ZeduloTech/gf180mcu-testchip2025/librelane/config.yaml

meta:
  version: 3
  flow: Chip
  substituting_steps:
  
    # Disable KLayout antenna check
    KLayout.Antenna: null
    Checker.KLayoutAntenna: null

    # Disable KLayout density check
    #KLayout.Density: null
    #Checker.KLayoutDensity: null

    # Save time during development
    # Enable for sign-off
    #KLayout.DRC: null
    #Checker.KLayoutDRC: null
    #OpenROAD.IRDropReport: null
    #Magic.DRC: null
    #Magic.Streamout: null
    #Checker.MagicDRC: null
    #KLayout.XOR: null
    #Netgen.LVS: null
    #Checker.LVS: null
    #Verilator.Lint: null
    
    Checker.YosysSynthChecks: null  # Fails due to multisources in PLL

DESIGN_NAME: chip_top
VERILOG_FILES:
- dir::../src/chip_top.sv
- dir::../src/chip_core.sv
- dir::../src/wb_reg.v
- dir::../src/wb_mux_5.v
- dir::../src/wb_switch.v
- dir::../src/wb_efuses.v
- dir::../src/wb_async_efuse.v
- dir::../src/sramtest/uspi_sramtest.sv

VERILOG_INCLUDE_DIRS: [ dir::../caravel/verilog/ ]

# Slightly smaller file sizes
PRIMARY_GDSII_STREAMOUT_TOOL: klayout

# SDC files
PNR_SDC_FILE: dir::chip_top.sdc
SIGNOFF_SDC_FILE: dir::chip_top.sdc
FALLBACK_SDC: dir::chip_top.sdc

# Power / ground nets
VDD_NETS:
- VDD
GND_NETS:
- VSS

# We need to add gf180mcu_fd_io__bi_24t
# due to the unused Y output for output only pads
IGNORE_DISCONNECTED_MODULES:
- gf180mcu_fd_io__bi_24t
- gf180mcu_ws_ip__id
- gf180mcu_ws_ip__logo

# Clock
#CLOCK_NET: i_chip_core.caravel/user_wb_clk_o
CLOCK_NET: i_chip_core.wb_clk_buf/Z

CLOCK_PERIOD: 45 # 22 MHz

# Increase timing margins
PL_RESIZER_HOLD_SLACK_MARGIN: 0.7
PL_RESIZER_SETUP_SLACK_MARGIN: 0.4
MAX_TRANSITION_CONSTRAINT: 1.0
PL_RESIZER_GATE_CLONING: False
PL_RESIZER_SETUP_BUFFERING: False
PL_KEEP_RESIZE_BELOW_OVERFLOW: 0
RSZ_DONT_TOUCH_RX: .*clk_buf

# Floorplanning
PL_TARGET_DENSITY_PCT: 25
GRT_ALLOW_CONGESTION: true

# PDN
PDN_CORE_RING: True
# Maximum metal width without slotting: 30um
PDN_CORE_RING_VWIDTH: 25
PDN_CORE_RING_HWIDTH: 25
PDN_CORE_RING_CONNECT_TO_PADS: True
PDN_ENABLE_PINS: False
PDN_CORE_VERTICAL_LAYER: Metal2
PDN_CORE_HORIZONTAL_LAYER: Metal3
PDN_HPITCH: 50

# To disable ports buffering & wire repair with dly cells as they degrade timing
PNR_EXCLUDED_CELL_FILE: dir::../caravel/librelane/pnr_exclude.cells

# To fix antennas
DESIGN_REPAIR_MAX_WIRE_LENGTH: 2000
DIODE_ON_PORTS: both
GRT_ANTENNA_MARGIN: 30
GRT_ANTENNA_ITERS: 10
DRT_ANTENNA_REPAIR_ITERS: 10

# Prevent false positive DRC errors in I/O cells
MAGIC_GDS_FLATGLOB:
# For contacts
- "*_CDNS_*"
# Foundry provided SRAMs
- "*$$*"
- "M1_N*"
- "M1_P*"
- "M2_M1*"
- "M3_M2*"
- "nmos_5p0*"
- "nmos_1p2*"
- "pmos_5p0*"
- "pmos_1p2*"
- "via1_*"
- "ypass_gate*"
- "G_ring_*"
# These additional cells must be flattened to get rid of 3.3V devices
# (DUALGATE drawn into high-level cells)
- "dcap_103*"
- "din_*"
- "mux821_*"
- "rdummy_*"
- "pmoscap_*"
- "xdec_*"
- "ypredec*"
- "xpredec*"
- "prexdec_*"
- "xdec8_*"
- "xdec16_*"
- "xdec32_*"
- "sa_*"

# Since we cannot meet the minimum density limit on Metal2,
# ignore active metal on previous and subsequent layers
# (DM.5_DM.7 and DM.4_DM.6). Dummy metal is moved to active
# metal during the precheck.
KLAYOUT_FILLER_OPTIONS:
  Metal2_ignore_active: true

# Because we have multiple power pads for one power domain
MAGIC_EXT_UNIQUE: notopports

MACROS:
  gf180mcu_ws_ip__id:
    gds:
      - dir::../ip/gf180mcu_ws_ip__id/gds/gf180mcu_ws_ip__id.gds
    lef:
      - dir::../ip/gf180mcu_ws_ip__id/lef/gf180mcu_ws_ip__id.lef
    vh:
      - dir::../ip/gf180mcu_ws_ip__id/vh/gf180mcu_ws_ip__id.v
    lib:
      "*":
        - dir::../ip/gf180mcu_ws_ip__id/lib/gf180mcu_ws_ip__id.lib
    instances:
      chip_id:
        location: [26, 26]
        orientation: N

  gf180mcu_ws_ip__logo:
    gds:
      - dir::../ip/gf180mcu_ws_ip__logo/gds/gf180mcu_ws_ip__logo.gds
    lef:
      - dir::../ip/gf180mcu_ws_ip__logo/lef/gf180mcu_ws_ip__logo.lef
    vh:
      - dir::../ip/gf180mcu_ws_ip__logo/vh/gf180mcu_ws_ip__logo.v
    lib:
      "*":
        - dir::../ip/gf180mcu_ws_ip__logo/lib/gf180mcu_ws_ip__logo.lib
    instances:
      wafer_space_logo:
        location: ["expr::$DIE_AREA[2] + -169.25", "expr::$DIE_AREA[3] + -169.25"]
        orientation: N
        
  caravel_core:
    gds:
      - dir::../caravel/final/gds/caravel_core.gds.gz
    lef:
      - dir::../caravel/final/lef/caravel_core.lef
    pnl:
      - dir::../caravel/final/pnl/caravel_core.pnl.v
    lib:
      "*tt*" : [ dir::../caravel/final/lib/nom_tt_025C_5v00/caravel_core__nom_tt_025C_5v00.lib ]
      "*ss*" : [ dir::../caravel/final/lib/max_ss_125C_4v50/caravel_core__max_ss_125C_4v50.lib ]
      "*ff*" : [ dir::../caravel/final/lib/min_ff_n40C_5v50/caravel_core__min_ff_n40C_5v50.lib ]
    spef:
      "*tt*" : [ dir::../caravel/final/spef/nom/caravel_core.nom.spef.gz ]
      "*ss*" : [ dir::../caravel/final/spef/max/caravel_core.max.spef.gz ]
      "*ff*" : [ dir::../caravel/final/spef/min/caravel_core.min.spef.gz ]
    instances:
      i_chip_core.caravel:
        location: [500, 500]
        orientation: N

  efuse_wb_mem_1024x32:
    gds:
      - dir::../ip/efuse_wb_mem_1024x32/efuse_wb_mem_1024x32.gds
    lef:
      - dir::../ip/efuse_wb_mem_1024x32/efuse_wb_mem_1024x32.lef
    pnl:
      - dir::../ip/efuse_wb_mem_1024x32/efuse_wb_mem_1024x32.pnl.v
    lib:
      "*tt*" : [ dir::../ip/efuse_wb_mem_1024x32/min_tt_025C_5v00/efuse_wb_mem_1024x32__min_tt_025C_5v00.lib ]
      "*ss*" : [ dir::../ip/efuse_wb_mem_1024x32/max_ss_125C_4v50/efuse_wb_mem_1024x32__max_ss_125C_4v50.lib ]
      "*ff*" : [ dir::../ip/efuse_wb_mem_1024x32/max_ff_n40C_5v50/efuse_wb_mem_1024x32__max_ff_n40C_5v50.lib ]
    instances:
      i_chip_core.wb_efuses.efuse_wb_1024x32:
        location: [500, 1600]
        orientation: S

  efuse_wb_mem_64x32:
    gds:
      - dir::../ip/efuse_wb_mem_64x32/efuse_wb_mem_64x32.gds
    lef:
      - dir::../ip/efuse_wb_mem_64x32/efuse_wb_mem_64x32.lef
    pnl:
      - dir::../ip/efuse_wb_mem_64x32/efuse_wb_mem_64x32.pnl.v
    lib:
      "*tt*" : [ dir::../ip/efuse_wb_mem_64x32/min_tt_025C_5v00/efuse_wb_mem_64x32__min_tt_025C_5v00.lib ]
      "*ss*" : [ dir::../ip/efuse_wb_mem_64x32/max_ss_125C_4v50/efuse_wb_mem_64x32__max_ss_125C_4v50.lib ]
      "*ff*" : [ dir::../ip/efuse_wb_mem_64x32/max_ff_n40C_5v50/efuse_wb_mem_64x32__max_ff_n40C_5v50.lib ]
    instances:
      i_chip_core.wb_efuses.efuse_wb_64x32:
        location: [3120, 3050]
        orientation: S

  efuse_wb_mem_128x8:
    gds:
      - dir::../ip/efuse_wb_mem_128x8/efuse_wb_mem_128x8.gds
    lef:
      - dir::../ip/efuse_wb_mem_128x8/efuse_wb_mem_128x8.lef
    pnl:
      - dir::../ip/efuse_wb_mem_128x8/efuse_wb_mem_128x8.pnl.v
    lib:
      "*tt*" : [ dir::../ip/efuse_wb_mem_128x8/min_tt_025C_5v00/efuse_wb_mem_128x8__min_tt_025C_5v00.lib ]
      "*ss*" : [ dir::../ip/efuse_wb_mem_128x8/max_ss_125C_4v50/efuse_wb_mem_128x8__max_ss_125C_4v50.lib ]
      "*ff*" : [ dir::../ip/efuse_wb_mem_128x8/max_ff_n40C_5v50/efuse_wb_mem_128x8__max_ff_n40C_5v50.lib ]
    instances:
      i_chip_core.wb_efuses.efuse_wb_128x8:
        location: [2550, 3020]
        orientation: S

  efuse_wb_mem_32x8:
    gds:
      - dir::../ip/efuse_wb_mem_32x8/efuse_wb_mem_32x8.gds
    lef:
      - dir::../ip/efuse_wb_mem_32x8/efuse_wb_mem_32x8.lef
    pnl:
      - dir::../ip/efuse_wb_mem_32x8/efuse_wb_mem_32x8.pnl.v
    lib:
      "*tt*" : [ dir::../ip/efuse_wb_mem_32x8/min_tt_025C_5v00/efuse_wb_mem_32x8__min_tt_025C_5v00.lib ]
      "*ss*" : [ dir::../ip/efuse_wb_mem_32x8/max_ss_125C_4v50/efuse_wb_mem_32x8__max_ss_125C_4v50.lib ]
      "*ff*" : [ dir::../ip/efuse_wb_mem_32x8/max_ff_n40C_5v50/efuse_wb_mem_32x8__max_ff_n40C_5v50.lib ]
    instances:
      i_chip_core.wb_efuses.efuse_wb_32x8:
        location: [2650, 3500]
        orientation: S

  efuse_spi_mem_256x8:
    gds:
      - dir::../ip/efuse_spi_mem_256x8/efuse_spi_mem_256x8.gds
    lef:
      - dir::../ip/efuse_spi_mem_256x8/efuse_spi_mem_256x8.lef
    pnl:
      - dir::../ip/efuse_spi_mem_256x8/efuse_spi_mem_256x8.pnl.v
    lib:
      "*tt*" : [ dir::../ip/efuse_spi_mem_256x8/min_tt_025C_5v00/efuse_spi_mem_256x8__min_tt_025C_5v00.lib ]
      "*ss*" : [ dir::../ip/efuse_spi_mem_256x8/max_ss_125C_4v50/efuse_spi_mem_256x8__max_ss_125C_4v50.lib ]
      "*ff*" : [ dir::../ip/efuse_spi_mem_256x8/max_ff_n40C_5v50/efuse_spi_mem_256x8__max_ff_n40C_5v50.lib ]
    instances:
      i_chip_core.efuse_spi:
        location: [1400, 3500]
        orientation: N

  efuse_async_mem_1x8:
    gds:
      - dir::../ip/efuse_async_mem_1x8/efuse_async_mem_1x8.gds
    lef:
      - dir::../ip/efuse_async_mem_1x8/efuse_async_mem_1x8.lef
    pnl:
      - dir::../ip/efuse_async_mem_1x8/efuse_async_mem_1x8.pnl.v
    lib:
      "*tt*" : [ dir::../ip/efuse_async_mem_1x8/min_tt_025C_5v00/efuse_async_mem_1x8__min_tt_025C_5v00.lib ]
      "*ss*" : [ dir::../ip/efuse_async_mem_1x8/max_ss_125C_4v50/efuse_async_mem_1x8__max_ss_125C_4v50.lib ]
      "*ff*" : [ dir::../ip/efuse_async_mem_1x8/max_ff_n40C_5v50/efuse_async_mem_1x8__max_ff_n40C_5v50.lib ]
    instances:
      i_chip_core.efuse_async:
        location: [1000, 3015]
        orientation: N
      i_chip_core.wb_efuses.efuse_wb_async.efuse[0].efuse_async:
        location: [2030, 3015]                    
        orientation: N                            
      i_chip_core.wb_efuses.efuse_wb_async.efuse[1].efuse_async:
        location: [2030, 3115]                    
        orientation: N                            
      i_chip_core.wb_efuses.efuse_wb_async.efuse[2].efuse_async:
        location: [2030, 3215]                    
        orientation: N                            
      i_chip_core.wb_efuses.efuse_wb_async.efuse[3].efuse_async:
        location: [2030, 3315]
        orientation: N

#495	0	4150
#350	145	4295
#280	215	4365
#245	250	4400

  gf180_ram_64x8_wrapper:
    gds:
      - dir::../ip/sram/gf180_ram_64x8_wrapper.gds.gz
    lef:
      - dir::../ip/sram/gf180_ram_64x8_wrapper.lef
    nl:
      - dir::../ip/sram/gf180_ram_64x8_wrapper.v
    lib:
      "*tt*" : [ dir::../ip/sram/gf180_ram_64x8_wrapper__tt_025C_5v00.lib ]
      "*ss*" : [ dir::../ip/sram/gf180_ram_64x8_wrapper__ss_125C_4v50.lib ]
      "*ff*" : [ dir::../ip/sram/gf180_ram_64x8_wrapper__ff_n40C_5v50.lib ]
      
    instances:  
      i_chip_core.sram_test_0.sram64_0:
        location: [500, 4350]
        orientation: N

  gf180_ram_128x8_wrapper:
    gds:
      - dir::../ip/sram/gf180_ram_128x8_wrapper.gds.gz
    lef:
      - dir::../ip/sram/gf180_ram_128x8_wrapper.lef
    nl:
      - dir::../ip/sram/gf180_ram_128x8_wrapper.v
    lib:
      "*tt*" : [ dir::../ip/sram/gf180_ram_128x8_wrapper__tt_025C_5v00.lib ]
      "*ss*" : [ dir::../ip/sram/gf180_ram_128x8_wrapper__ss_125C_4v50.lib ]
      "*ff*" : [ dir::../ip/sram/gf180_ram_128x8_wrapper__ff_n40C_5v50.lib ]
      
    instances:  
      i_chip_core.sram_test_0.sram128_0:
        location: [1000, 4315]
        orientation: N

  gf180_ram_256x8_wrapper:
    gds:
      - dir::../ip/sram/gf180_ram_256x8_wrapper.gds.gz
    lef:
      - dir::../ip/sram/gf180_ram_256x8_wrapper.lef
    nl:
      - dir::../ip/sram/gf180_ram_256x8_wrapper.v
    lib:
      "*tt*" : [ dir::../ip/sram/gf180_ram_256x8_wrapper__tt_025C_5v00.lib ]
      "*ss*" : [ dir::../ip/sram/gf180_ram_256x8_wrapper__ss_125C_4v50.lib ]
      "*ff*" : [ dir::../ip/sram/gf180_ram_256x8_wrapper__ff_n40C_5v50.lib ]
      
    instances:  
      i_chip_core.sram_test_0.sram256_0:
        location: [1500, 4245]
        orientation: N

  gf180_ram_512x8_wrapper:
    gds:
      - dir::../ip/sram/gf180_ram_512x8_wrapper.gds.gz
    lef:
      - dir::../ip/sram/gf180_ram_512x8_wrapper.lef
    nl:
      - dir::../ip/sram/gf180_ram_512x8_wrapper.v
    lib:
      "*tt*" : [ dir::../ip/sram/gf180mcu_fd_ip_sram__sram512x8m8wm1__tt_025C_5v00.lib ]
      "*ss*" : [ dir::../ip/sram/gf180mcu_fd_ip_sram__sram512x8m8wm1__ss_125C_4v50.lib ]
      "*ff*" : [ dir::../ip/sram/gf180mcu_fd_ip_sram__sram512x8m8wm1__ff_n40C_5v50.lib ]
      
    instances:  
      i_chip_core.sram_test_0.sram512_0:
        location: [2000, 4100]
        orientation: N

  uart2gpi:
    gds:
      - dir::../uart2gpi/final/gds/uart2gpi.gds.gz
    lef:
      - dir::../uart2gpi/final/lef/uart2gpi.lef
    nl:
      - dir::../uart2gpi/final/nl/uart2gpi.nl.v
    lib:
      "*tt*" : [ dir::../uart2gpi/final/lib/nom_tt_025C_5v00/uart2gpi__nom_tt_025C_5v00.lib ]
      "*ss*" : [ dir::../uart2gpi/final/lib/nom_ss_125C_4v50/uart2gpi__nom_ss_125C_4v50.lib ]
      "*ff*" : [ dir::../uart2gpi/final/lib/nom_ff_n40C_5v50/uart2gpi__nom_ff_n40C_5v50.lib ]
      
    instances:  
      i_chip_core.uart2gpi_0:
        location: [500, 3450]
        orientation: N


# Make sure netgen doesn't create 'no_connect' nets
# Not needed since netgen 1.5.303
LVS_FLATTEN_CELLS:
- gf180mcu_ws_ip__id
- gf180mcu_ws_ip__logo

# gf180mcu_ws_ip__id/logo has no ports and components
# therefore make it an abstract cell in the layout
MAGIC_EXT_ABSTRACT_CELLS:
- gf180mcu_ws_ip__id
- gf180mcu_ws_ip__logo
