ZeduloTech/gf180mcu-testchip2025/src/chip_top.sv

// SPDX-FileCopyrightText: © 2025 Project Template Contributors
// SPDX-License-Identifier: Apache-2.0

`default_nettype none

`include "slot_defines.svh"

module chip_top #(
    // Power/ground pads for core and I/O
    parameter NUM_DVDD_PADS = `NUM_DVDD_PADS,
    parameter NUM_DVSS_PADS = `NUM_DVSS_PADS,

    // Signal pads
    parameter NUM_INPUT_PADS = `NUM_INPUT_PADS,
    parameter NUM_BIDIR_PADS = `NUM_BIDIR_PADS,
    parameter NUM_ANALOG_PADS = `NUM_ANALOG_PADS
    )(
    `ifdef USE_POWER_PINS
    inout  wire VDD,
    inout  wire VSS,
    `endif

    inout  wire clk_PAD,
    inout  wire rst_n_PAD,

    `ifndef NO_ANALOG_PADS    
    inout  wire [NUM_ANALOG_PADS-1:0] analog_PAD,
    `endif
    
    inout  wire [NUM_INPUT_PADS-1:0] input_PAD,
    inout  wire [NUM_BIDIR_PADS-1:0] bidir_PAD
);

    wire clk_PAD2CORE;
    wire rst_n_PAD2CORE;
    
    wire [NUM_INPUT_PADS-1:0] input_PAD2CORE;
    wire [NUM_INPUT_PADS-1:0] input_CORE2PAD_PU;
    wire [NUM_INPUT_PADS-1:0] input_CORE2PAD_PD;

    wire [NUM_BIDIR_PADS-1:0] bidir_PAD2CORE;
    wire [NUM_BIDIR_PADS-1:0] bidir_CORE2PAD;
    wire [NUM_BIDIR_PADS-1:0] bidir_CORE2PAD_OE;
    wire [NUM_BIDIR_PADS-1:0] bidir_CORE2PAD_CS;
    wire [NUM_BIDIR_PADS-1:0] bidir_CORE2PAD_SL;
    wire [NUM_BIDIR_PADS-1:0] bidir_CORE2PAD_IE;
    wire [NUM_BIDIR_PADS-1:0] bidir_CORE2PAD_PU;
    wire [NUM_BIDIR_PADS-1:0] bidir_CORE2PAD_PD;

    // Power/ground pad instances
    generate
    for (genvar i=0; i<NUM_DVDD_PADS; i++) begin : dvdd_pads
        (* keep *)
        gf180mcu_ws_io__dvdd pad (
            `ifdef USE_POWER_PINS
            .DVDD   (VDD),
            .DVSS   (VSS),
            .VSS    (VSS)
            `endif
        );
    end
    
    for (genvar i=0; i<NUM_DVSS_PADS; i++) begin : dvss_pads
        (* keep *)
        gf180mcu_ws_io__dvss pad (
            `ifdef USE_POWER_PINS
            .DVDD   (VDD),
            .DVSS   (VSS),
            .VDD    (VDD)
            `endif
        );
    end
    endgenerate

    // Signal IO pad instances

    // Schmitt trigger
    gf180mcu_fd_io__in_s clk_pad (
        `ifdef USE_POWER_PINS
        .DVDD   (VDD),
        .DVSS   (VSS),
        .VDD    (VDD),
        .VSS    (VSS),
        `endif
    
        .Y      (clk_PAD2CORE),
        .PAD    (clk_PAD),
        
        .PU     (1'b0),
        .PD     (1'b0)
    );
    
    // Normal input
    gf180mcu_fd_io__in_c rst_n_pad (
        `ifdef USE_POWER_PINS
        .DVDD   (VDD),
        .DVSS   (VSS),
        .VDD    (VDD),
        .VSS    (VSS),
        `endif
    
        .Y      (rst_n_PAD2CORE),
        .PAD    (rst_n_PAD),
        
        .PU     (1'b0),
        .PD     (1'b0)
    );

    generate
    for (genvar i=0; i<NUM_INPUT_PADS; i++) begin : inputs
        (* keep *)
        gf180mcu_fd_io__in_c pad (
            `ifdef USE_POWER_PINS
            .DVDD   (VDD),
            .DVSS   (VSS),
            .VDD    (VDD),
            .VSS    (VSS),
            `endif
        
            .Y      (input_PAD2CORE[i]),
            .PAD    (input_PAD[i]),
            
            .PU     (input_CORE2PAD_PU[i]),
            .PD     (input_CORE2PAD_PD[i])
        );
    end
    endgenerate

    generate
    for (genvar i=0; i<NUM_BIDIR_PADS; i++) begin : bidir
        (* keep *)
        gf180mcu_fd_io__bi_24t pad (
            `ifdef USE_POWER_PINS
            .DVDD   (VDD),
            .DVSS   (VSS),
            .VDD    (VDD),
            .VSS    (VSS),
            `endif
        
            .A      (bidir_CORE2PAD[i]),
            .OE     (bidir_CORE2PAD_OE[i]),
            .Y      (bidir_PAD2CORE[i]),
            .PAD    (bidir_PAD[i]),
            
            .CS     (bidir_CORE2PAD_CS[i]),
            .SL     (bidir_CORE2PAD_SL[i]),
            .IE     (bidir_CORE2PAD_IE[i]),

            .PU     (bidir_CORE2PAD_PU[i]),
            .PD     (bidir_CORE2PAD_PD[i])
        );
    end
    endgenerate

    `ifndef NO_ANALOG_PADS
    generate
    for (genvar i=0; i<NUM_ANALOG_PADS; i++) begin : analog
        (* keep *)
        gf180mcu_fd_io__asig_5p0 pad (
            `ifdef USE_POWER_PINS
            .DVDD   (VDD),
            .DVSS   (VSS),
            .VDD    (VDD),
            .VSS    (VSS),
            `endif
            .ASIG5V (analog_PAD[i])
        );
    end
    endgenerate
    `endif

    // Core design

    chip_core #(
        .NUM_INPUT_PADS  (NUM_INPUT_PADS),
        .NUM_BIDIR_PADS  (NUM_BIDIR_PADS),
        .NUM_ANALOG_PADS (NUM_ANALOG_PADS)
    ) i_chip_core (
        `ifdef USE_POWER_PINS
        .VDD        (VDD),
        .VSS        (VSS),
        `endif
    
        .clk        (clk_PAD2CORE),
        .rst_n      (rst_n_PAD2CORE),
    
        .input_in   (input_PAD2CORE),
        .input_pu   (input_CORE2PAD_PU),
        .input_pd   (input_CORE2PAD_PD),

        `ifndef NO_ANALOG_PADS
        .analog     (analog_PAD),
        `endif

        .bidir_in   (bidir_PAD2CORE),
        .bidir_out  (bidir_CORE2PAD),
        .bidir_oe   (bidir_CORE2PAD_OE),
        .bidir_cs   (bidir_CORE2PAD_CS),
        .bidir_sl   (bidir_CORE2PAD_SL),
        .bidir_ie   (bidir_CORE2PAD_IE),
        .bidir_pu   (bidir_CORE2PAD_PU),
        .bidir_pd   (bidir_CORE2PAD_PD)
    );
    
    // Chip ID - do not remove, necessary for tapeout
    (* keep *)
    gf180mcu_ws_ip__id chip_id ();
    
    // wafer.space logo - can be removed
    (* keep *)
    gf180mcu_ws_ip__logo wafer_space_logo ();

endmodule

`default_nettype wire
