ZeduloTech/gf180mcu-testchip2025/caravel/ring_osc2x13/final/nl/ring_osc2x13.nl.v

module ring_osc2x13 (reset,
    clockp,
    trim);
 input reset;
 output [1:0] clockp;
 input [25:0] trim;

 wire \c[0] ;
 wire \c[1] ;
 wire \dstage[10].id.d0 ;
 wire \dstage[10].id.d1 ;
 wire \dstage[10].id.d2 ;
 wire \dstage[10].id.in ;
 wire \dstage[10].id.ltrim[0] ;
 wire \dstage[10].id.ltrim[1] ;
 wire \dstage[10].id.ltrimb[0] ;
 wire \dstage[10].id.ltrimb[1] ;
 wire \dstage[10].id.not_edge ;
 wire \dstage[10].id.nreset ;
 wire \dstage[10].id.out ;
 wire \dstage[10].id.out_del ;
 wire \dstage[10].id.prev_in ;
 wire \dstage[10].id.ts ;
 wire \dstage[11].id.d0 ;
 wire \dstage[11].id.d1 ;
 wire \dstage[11].id.d2 ;
 wire \dstage[11].id.ltrim[0] ;
 wire \dstage[11].id.ltrim[1] ;
 wire \dstage[11].id.ltrimb[0] ;
 wire \dstage[11].id.ltrimb[1] ;
 wire \dstage[11].id.not_edge ;
 wire \dstage[11].id.out ;
 wire \dstage[11].id.out_del ;
 wire \dstage[11].id.prev_in ;
 wire \dstage[11].id.ts ;
 wire \dstage[2].id.d0 ;
 wire \dstage[2].id.d1 ;
 wire \dstage[2].id.d2 ;
 wire \dstage[2].id.in ;
 wire \dstage[2].id.ltrim[0] ;
 wire \dstage[2].id.ltrim[1] ;
 wire \dstage[2].id.ltrimb[0] ;
 wire \dstage[2].id.ltrimb[1] ;
 wire \dstage[2].id.not_edge ;
 wire \dstage[2].id.out ;
 wire \dstage[2].id.out_del ;
 wire \dstage[2].id.prev_in ;
 wire \dstage[2].id.ts ;
 wire \dstage[3].id.d0 ;
 wire \dstage[3].id.d1 ;
 wire \dstage[3].id.d2 ;
 wire \dstage[3].id.ltrim[0] ;
 wire \dstage[3].id.ltrim[1] ;
 wire \dstage[3].id.ltrimb[0] ;
 wire \dstage[3].id.ltrimb[1] ;
 wire \dstage[3].id.not_edge ;
 wire \dstage[3].id.out ;
 wire \dstage[3].id.out_del ;
 wire \dstage[3].id.prev_in ;
 wire \dstage[3].id.ts ;
 wire \dstage[4].id.d0 ;
 wire \dstage[4].id.d1 ;
 wire \dstage[4].id.d2 ;
 wire \dstage[4].id.ltrim[0] ;
 wire \dstage[4].id.ltrim[1] ;
 wire \dstage[4].id.ltrimb[0] ;
 wire \dstage[4].id.ltrimb[1] ;
 wire \dstage[4].id.not_edge ;
 wire \dstage[4].id.out ;
 wire \dstage[4].id.out_del ;
 wire \dstage[4].id.ts ;
 wire \dstage[5].id.d0 ;
 wire \dstage[5].id.d1 ;
 wire \dstage[5].id.d2 ;
 wire \dstage[5].id.ltrim[0] ;
 wire \dstage[5].id.ltrim[1] ;
 wire \dstage[5].id.ltrimb[0] ;
 wire \dstage[5].id.ltrimb[1] ;
 wire \dstage[5].id.not_edge ;
 wire \dstage[5].id.out ;
 wire \dstage[5].id.out_del ;
 wire \dstage[5].id.ts ;
 wire \dstage[6].id.d0 ;
 wire \dstage[6].id.d1 ;
 wire \dstage[6].id.d2 ;
 wire \dstage[6].id.ltrim[0] ;
 wire \dstage[6].id.ltrim[1] ;
 wire \dstage[6].id.ltrimb[0] ;
 wire \dstage[6].id.ltrimb[1] ;
 wire \dstage[6].id.not_edge ;
 wire \dstage[6].id.out ;
 wire \dstage[6].id.out_del ;
 wire \dstage[6].id.ts ;
 wire \dstage[7].id.d0 ;
 wire \dstage[7].id.d1 ;
 wire \dstage[7].id.d2 ;
 wire \dstage[7].id.ltrim[0] ;
 wire \dstage[7].id.ltrim[1] ;
 wire \dstage[7].id.ltrimb[0] ;
 wire \dstage[7].id.ltrimb[1] ;
 wire \dstage[7].id.not_edge ;
 wire \dstage[7].id.out_del ;
 wire \dstage[7].id.ts ;
 wire \dstage[8].id.d0 ;
 wire \dstage[8].id.d1 ;
 wire \dstage[8].id.d2 ;
 wire \dstage[8].id.ltrim[0] ;
 wire \dstage[8].id.ltrim[1] ;
 wire \dstage[8].id.ltrimb[0] ;
 wire \dstage[8].id.ltrimb[1] ;
 wire \dstage[8].id.not_edge ;
 wire \dstage[8].id.out_del ;
 wire \dstage[8].id.ts ;
 wire \dstage[9].id.d0 ;
 wire \dstage[9].id.d1 ;
 wire \dstage[9].id.d2 ;
 wire \dstage[9].id.ltrim[0] ;
 wire \dstage[9].id.ltrim[1] ;
 wire \dstage[9].id.ltrimb[0] ;
 wire \dstage[9].id.ltrimb[1] ;
 wire \dstage[9].id.not_edge ;
 wire \dstage[9].id.out_del ;
 wire \dstage[9].id.ts ;
 wire \id0.d0 ;
 wire \id0.d1 ;
 wire \id0.d2 ;
 wire \id0.ltrim[0] ;
 wire \id0.ltrim[1] ;
 wire \id0.ltrimb[0] ;
 wire \id0.ltrimb[1] ;
 wire \id0.not_edge ;
 wire \id0.out_del ;
 wire \id0.ts ;
 wire \id1.d0 ;
 wire \id1.d1 ;
 wire \id1.d2 ;
 wire \id1.ltrim[0] ;
 wire \id1.ltrim[1] ;
 wire \id1.ltrimb[0] ;
 wire \id1.ltrimb[1] ;
 wire \id1.not_edge ;
 wire \id1.out_del ;
 wire \id1.ts ;
 wire \iss.ctrl0b ;
 wire \iss.d0 ;
 wire \iss.d1 ;
 wire \iss.d2 ;
 wire \iss.ltrim[0] ;
 wire \iss.ltrim[1] ;
 wire \iss.not_edge ;
 wire \iss.nreset_del ;
 wire \iss.out_del ;
 wire \iss.out_precg ;
 wire \iss.trim1b ;
 wire net;

 gf180mcu_fd_sc_mcu7t5v0__clkinv_1 _0_ (.I(reset),
    .ZN(\dstage[10].id.nreset ));
 gf180mcu_fd_sc_mcu7t5v0__clkbuf_2 \dstage[10].id.deglitch_buf  (.I(\dstage[10].id.out ),
    .Z(\dstage[10].id.out_del ));
 gf180mcu_fd_sc_mcu7t5v0__clkbuf_2 \dstage[10].id.delaybuf0  (.I(\dstage[10].id.in ),
    .Z(\dstage[10].id.ts ));
 gf180mcu_fd_sc_mcu7t5v0__clkbuf_1 \dstage[10].id.delaybuf1  (.I(\dstage[10].id.ts ),
    .Z(\dstage[10].id.d0 ));
 gf180mcu_fd_sc_mcu7t5v0__invz_2 \dstage[10].id.delayen0  (.EN(\dstage[10].id.ltrim[0] ),
    .I(\dstage[10].id.d2 ),
    .ZN(\dstage[10].id.out ));
 gf180mcu_fd_sc_mcu7t5v0__invz_2 \dstage[10].id.delayen1  (.EN(\dstage[10].id.ltrim[1] ),
    .I(\dstage[10].id.d0 ),
    .ZN(\dstage[10].id.d1 ));
 gf180mcu_fd_sc_mcu7t5v0__invz_8 \dstage[10].id.delayenb0  (.EN(\dstage[10].id.ltrimb[0] ),
    .I(\dstage[10].id.ts ),
    .ZN(\dstage[10].id.out ));
 gf180mcu_fd_sc_mcu7t5v0__invz_4 \dstage[10].id.delayenb1  (.EN(\dstage[10].id.ltrimb[1] ),
    .I(\dstage[10].id.ts ),
    .ZN(\dstage[10].id.d1 ));
 gf180mcu_fd_sc_mcu7t5v0__clkinv_2 \dstage[10].id.delayint0  (.I(\dstage[10].id.d1 ),
    .ZN(\dstage[10].id.d2 ));
 gf180mcu_fd_sc_mcu7t5v0__hold \dstage[10].id.hold_d1  (.Z(\dstage[10].id.d1 ));
 gf180mcu_fd_sc_mcu7t5v0__hold \dstage[10].id.hold_out  (.Z(\dstage[10].id.out ));
 gf180mcu_fd_sc_mcu7t5v0__latrnq_1 \dstage[10].id.t0_latch  (.D(trim[10]),
    .E(\dstage[10].id.not_edge ),
    .RN(\dstage[10].id.nreset ),
    .Q(\dstage[10].id.ltrim[0] ));
 gf180mcu_fd_sc_mcu7t5v0__latrnq_1 \dstage[10].id.t1_latch  (.D(trim[23]),
    .E(\dstage[10].id.not_edge ),
    .RN(\dstage[10].id.nreset ),
    .Q(\dstage[10].id.ltrim[1] ));
 gf180mcu_fd_sc_mcu7t5v0__inv_1 \dstage[10].id.trim0bar  (.I(\dstage[10].id.ltrim[0] ),
    .ZN(\dstage[10].id.ltrimb[0] ));
 gf180mcu_fd_sc_mcu7t5v0__inv_1 \dstage[10].id.trim1bar  (.I(\dstage[10].id.ltrim[1] ),
    .ZN(\dstage[10].id.ltrimb[1] ));
 gf180mcu_fd_sc_mcu7t5v0__xor2_1 \dstage[10].id.trim_inhibit  (.A1(\dstage[10].id.prev_in ),
    .A2(\dstage[10].id.out_del ),
    .Z(\dstage[10].id.not_edge ));
 gf180mcu_fd_sc_mcu7t5v0__clkbuf_2 \dstage[11].id.deglitch_buf  (.I(\dstage[11].id.out ),
    .Z(\dstage[11].id.out_del ));
 gf180mcu_fd_sc_mcu7t5v0__clkbuf_2 \dstage[11].id.delaybuf0  (.I(\dstage[10].id.out ),
    .Z(\dstage[11].id.ts ));
 gf180mcu_fd_sc_mcu7t5v0__clkbuf_1 \dstage[11].id.delaybuf1  (.I(\dstage[11].id.ts ),
    .Z(\dstage[11].id.d0 ));
 gf180mcu_fd_sc_mcu7t5v0__invz_2 \dstage[11].id.delayen0  (.EN(\dstage[11].id.ltrim[0] ),
    .I(\dstage[11].id.d2 ),
    .ZN(\dstage[11].id.out ));
 gf180mcu_fd_sc_mcu7t5v0__invz_2 \dstage[11].id.delayen1  (.EN(\dstage[11].id.ltrim[1] ),
    .I(\dstage[11].id.d0 ),
    .ZN(\dstage[11].id.d1 ));
 gf180mcu_fd_sc_mcu7t5v0__invz_8 \dstage[11].id.delayenb0  (.EN(\dstage[11].id.ltrimb[0] ),
    .I(\dstage[11].id.ts ),
    .ZN(\dstage[11].id.out ));
 gf180mcu_fd_sc_mcu7t5v0__invz_4 \dstage[11].id.delayenb1  (.EN(\dstage[11].id.ltrimb[1] ),
    .I(\dstage[11].id.ts ),
    .ZN(\dstage[11].id.d1 ));
 gf180mcu_fd_sc_mcu7t5v0__clkinv_2 \dstage[11].id.delayint0  (.I(\dstage[11].id.d1 ),
    .ZN(\dstage[11].id.d2 ));
 gf180mcu_fd_sc_mcu7t5v0__hold \dstage[11].id.hold_d1  (.Z(\dstage[11].id.d1 ));
 gf180mcu_fd_sc_mcu7t5v0__hold \dstage[11].id.hold_out  (.Z(\dstage[11].id.out ));
 gf180mcu_fd_sc_mcu7t5v0__latrnq_1 \dstage[11].id.t0_latch  (.D(trim[11]),
    .E(\dstage[11].id.not_edge ),
    .RN(\dstage[10].id.nreset ),
    .Q(\dstage[11].id.ltrim[0] ));
 gf180mcu_fd_sc_mcu7t5v0__latrnq_1 \dstage[11].id.t1_latch  (.D(trim[24]),
    .E(\dstage[11].id.not_edge ),
    .RN(\dstage[10].id.nreset ),
    .Q(\dstage[11].id.ltrim[1] ));
 gf180mcu_fd_sc_mcu7t5v0__inv_1 \dstage[11].id.trim0bar  (.I(\dstage[11].id.ltrim[0] ),
    .ZN(\dstage[11].id.ltrimb[0] ));
 gf180mcu_fd_sc_mcu7t5v0__inv_1 \dstage[11].id.trim1bar  (.I(\dstage[11].id.ltrim[1] ),
    .ZN(\dstage[11].id.ltrimb[1] ));
 gf180mcu_fd_sc_mcu7t5v0__xor2_1 \dstage[11].id.trim_inhibit  (.A1(\dstage[11].id.prev_in ),
    .A2(\dstage[11].id.out_del ),
    .Z(\dstage[11].id.not_edge ));
 gf180mcu_fd_sc_mcu7t5v0__clkbuf_2 \dstage[2].id.deglitch_buf  (.I(\dstage[2].id.out ),
    .Z(\dstage[2].id.out_del ));
 gf180mcu_fd_sc_mcu7t5v0__clkbuf_2 \dstage[2].id.delaybuf0  (.I(\dstage[2].id.in ),
    .Z(\dstage[2].id.ts ));
 gf180mcu_fd_sc_mcu7t5v0__clkbuf_1 \dstage[2].id.delaybuf1  (.I(\dstage[2].id.ts ),
    .Z(\dstage[2].id.d0 ));
 gf180mcu_fd_sc_mcu7t5v0__invz_2 \dstage[2].id.delayen0  (.EN(\dstage[2].id.ltrim[0] ),
    .I(\dstage[2].id.d2 ),
    .ZN(\dstage[2].id.out ));
 gf180mcu_fd_sc_mcu7t5v0__invz_2 \dstage[2].id.delayen1  (.EN(\dstage[2].id.ltrim[1] ),
    .I(\dstage[2].id.d0 ),
    .ZN(\dstage[2].id.d1 ));
 gf180mcu_fd_sc_mcu7t5v0__invz_8 \dstage[2].id.delayenb0  (.EN(\dstage[2].id.ltrimb[0] ),
    .I(\dstage[2].id.ts ),
    .ZN(\dstage[2].id.out ));
 gf180mcu_fd_sc_mcu7t5v0__invz_4 \dstage[2].id.delayenb1  (.EN(\dstage[2].id.ltrimb[1] ),
    .I(\dstage[2].id.ts ),
    .ZN(\dstage[2].id.d1 ));
 gf180mcu_fd_sc_mcu7t5v0__clkinv_2 \dstage[2].id.delayint0  (.I(\dstage[2].id.d1 ),
    .ZN(\dstage[2].id.d2 ));
 gf180mcu_fd_sc_mcu7t5v0__hold \dstage[2].id.hold_d1  (.Z(\dstage[2].id.d1 ));
 gf180mcu_fd_sc_mcu7t5v0__hold \dstage[2].id.hold_out  (.Z(\dstage[2].id.out ));
 gf180mcu_fd_sc_mcu7t5v0__latrnq_1 \dstage[2].id.t0_latch  (.D(trim[2]),
    .E(\dstage[2].id.not_edge ),
    .RN(\dstage[10].id.nreset ),
    .Q(\dstage[2].id.ltrim[0] ));
 gf180mcu_fd_sc_mcu7t5v0__latrnq_1 \dstage[2].id.t1_latch  (.D(trim[15]),
    .E(\dstage[2].id.not_edge ),
    .RN(\dstage[10].id.nreset ),
    .Q(\dstage[2].id.ltrim[1] ));
 gf180mcu_fd_sc_mcu7t5v0__inv_1 \dstage[2].id.trim0bar  (.I(\dstage[2].id.ltrim[0] ),
    .ZN(\dstage[2].id.ltrimb[0] ));
 gf180mcu_fd_sc_mcu7t5v0__inv_1 \dstage[2].id.trim1bar  (.I(\dstage[2].id.ltrim[1] ),
    .ZN(\dstage[2].id.ltrimb[1] ));
 gf180mcu_fd_sc_mcu7t5v0__xor2_1 \dstage[2].id.trim_inhibit  (.A1(\dstage[2].id.prev_in ),
    .A2(\dstage[2].id.out_del ),
    .Z(\dstage[2].id.not_edge ));
 gf180mcu_fd_sc_mcu7t5v0__clkbuf_2 \dstage[3].id.deglitch_buf  (.I(\dstage[3].id.out ),
    .Z(\dstage[3].id.out_del ));
 gf180mcu_fd_sc_mcu7t5v0__clkbuf_2 \dstage[3].id.delaybuf0  (.I(\dstage[2].id.out ),
    .Z(\dstage[3].id.ts ));
 gf180mcu_fd_sc_mcu7t5v0__clkbuf_1 \dstage[3].id.delaybuf1  (.I(\dstage[3].id.ts ),
    .Z(\dstage[3].id.d0 ));
 gf180mcu_fd_sc_mcu7t5v0__invz_2 \dstage[3].id.delayen0  (.EN(\dstage[3].id.ltrim[0] ),
    .I(\dstage[3].id.d2 ),
    .ZN(\dstage[3].id.out ));
 gf180mcu_fd_sc_mcu7t5v0__invz_2 \dstage[3].id.delayen1  (.EN(\dstage[3].id.ltrim[1] ),
    .I(\dstage[3].id.d0 ),
    .ZN(\dstage[3].id.d1 ));
 gf180mcu_fd_sc_mcu7t5v0__invz_8 \dstage[3].id.delayenb0  (.EN(\dstage[3].id.ltrimb[0] ),
    .I(\dstage[3].id.ts ),
    .ZN(\dstage[3].id.out ));
 gf180mcu_fd_sc_mcu7t5v0__invz_4 \dstage[3].id.delayenb1  (.EN(\dstage[3].id.ltrimb[1] ),
    .I(\dstage[3].id.ts ),
    .ZN(\dstage[3].id.d1 ));
 gf180mcu_fd_sc_mcu7t5v0__clkinv_2 \dstage[3].id.delayint0  (.I(\dstage[3].id.d1 ),
    .ZN(\dstage[3].id.d2 ));
 gf180mcu_fd_sc_mcu7t5v0__hold \dstage[3].id.hold_d1  (.Z(\dstage[3].id.d1 ));
 gf180mcu_fd_sc_mcu7t5v0__hold \dstage[3].id.hold_out  (.Z(\dstage[3].id.out ));
 gf180mcu_fd_sc_mcu7t5v0__latrnq_1 \dstage[3].id.t0_latch  (.D(trim[3]),
    .E(\dstage[3].id.not_edge ),
    .RN(\dstage[10].id.nreset ),
    .Q(\dstage[3].id.ltrim[0] ));
 gf180mcu_fd_sc_mcu7t5v0__latrnq_1 \dstage[3].id.t1_latch  (.D(trim[16]),
    .E(\dstage[3].id.not_edge ),
    .RN(\dstage[10].id.nreset ),
    .Q(\dstage[3].id.ltrim[1] ));
 gf180mcu_fd_sc_mcu7t5v0__inv_1 \dstage[3].id.trim0bar  (.I(\dstage[3].id.ltrim[0] ),
    .ZN(\dstage[3].id.ltrimb[0] ));
 gf180mcu_fd_sc_mcu7t5v0__inv_1 \dstage[3].id.trim1bar  (.I(\dstage[3].id.ltrim[1] ),
    .ZN(\dstage[3].id.ltrimb[1] ));
 gf180mcu_fd_sc_mcu7t5v0__xor2_1 \dstage[3].id.trim_inhibit  (.A1(\dstage[3].id.prev_in ),
    .A2(\dstage[3].id.out_del ),
    .Z(\dstage[3].id.not_edge ));
 gf180mcu_fd_sc_mcu7t5v0__clkbuf_2 \dstage[4].id.deglitch_buf  (.I(\dstage[4].id.out ),
    .Z(\dstage[4].id.out_del ));
 gf180mcu_fd_sc_mcu7t5v0__clkbuf_2 \dstage[4].id.delaybuf0  (.I(\dstage[3].id.out ),
    .Z(\dstage[4].id.ts ));
 gf180mcu_fd_sc_mcu7t5v0__clkbuf_1 \dstage[4].id.delaybuf1  (.I(\dstage[4].id.ts ),
    .Z(\dstage[4].id.d0 ));
 gf180mcu_fd_sc_mcu7t5v0__invz_2 \dstage[4].id.delayen0  (.EN(\dstage[4].id.ltrim[0] ),
    .I(\dstage[4].id.d2 ),
    .ZN(\dstage[4].id.out ));
 gf180mcu_fd_sc_mcu7t5v0__invz_2 \dstage[4].id.delayen1  (.EN(\dstage[4].id.ltrim[1] ),
    .I(\dstage[4].id.d0 ),
    .ZN(\dstage[4].id.d1 ));
 gf180mcu_fd_sc_mcu7t5v0__invz_8 \dstage[4].id.delayenb0  (.EN(\dstage[4].id.ltrimb[0] ),
    .I(\dstage[4].id.ts ),
    .ZN(\dstage[4].id.out ));
 gf180mcu_fd_sc_mcu7t5v0__invz_4 \dstage[4].id.delayenb1  (.EN(\dstage[4].id.ltrimb[1] ),
    .I(\dstage[4].id.ts ),
    .ZN(\dstage[4].id.d1 ));
 gf180mcu_fd_sc_mcu7t5v0__clkinv_2 \dstage[4].id.delayint0  (.I(\dstage[4].id.d1 ),
    .ZN(\dstage[4].id.d2 ));
 gf180mcu_fd_sc_mcu7t5v0__hold \dstage[4].id.hold_d1  (.Z(\dstage[4].id.d1 ));
 gf180mcu_fd_sc_mcu7t5v0__hold \dstage[4].id.hold_out  (.Z(\dstage[4].id.out ));
 gf180mcu_fd_sc_mcu7t5v0__latrnq_1 \dstage[4].id.t0_latch  (.D(trim[4]),
    .E(\dstage[4].id.not_edge ),
    .RN(\dstage[10].id.nreset ),
    .Q(\dstage[4].id.ltrim[0] ));
 gf180mcu_fd_sc_mcu7t5v0__latrnq_1 \dstage[4].id.t1_latch  (.D(trim[17]),
    .E(\dstage[4].id.not_edge ),
    .RN(\dstage[10].id.nreset ),
    .Q(\dstage[4].id.ltrim[1] ));
 gf180mcu_fd_sc_mcu7t5v0__inv_1 \dstage[4].id.trim0bar  (.I(\dstage[4].id.ltrim[0] ),
    .ZN(\dstage[4].id.ltrimb[0] ));
 gf180mcu_fd_sc_mcu7t5v0__inv_1 \dstage[4].id.trim1bar  (.I(\dstage[4].id.ltrim[1] ),
    .ZN(\dstage[4].id.ltrimb[1] ));
 gf180mcu_fd_sc_mcu7t5v0__xor2_1 \dstage[4].id.trim_inhibit  (.A1(\dstage[2].id.in ),
    .A2(\dstage[4].id.out_del ),
    .Z(\dstage[4].id.not_edge ));
 gf180mcu_fd_sc_mcu7t5v0__clkbuf_2 \dstage[5].id.deglitch_buf  (.I(\dstage[5].id.out ),
    .Z(\dstage[5].id.out_del ));
 gf180mcu_fd_sc_mcu7t5v0__clkbuf_2 \dstage[5].id.delaybuf0  (.I(\dstage[4].id.out ),
    .Z(\dstage[5].id.ts ));
 gf180mcu_fd_sc_mcu7t5v0__clkbuf_1 \dstage[5].id.delaybuf1  (.I(\dstage[5].id.ts ),
    .Z(\dstage[5].id.d0 ));
 gf180mcu_fd_sc_mcu7t5v0__invz_2 \dstage[5].id.delayen0  (.EN(\dstage[5].id.ltrim[0] ),
    .I(\dstage[5].id.d2 ),
    .ZN(\dstage[5].id.out ));
 gf180mcu_fd_sc_mcu7t5v0__invz_2 \dstage[5].id.delayen1  (.EN(\dstage[5].id.ltrim[1] ),
    .I(\dstage[5].id.d0 ),
    .ZN(\dstage[5].id.d1 ));
 gf180mcu_fd_sc_mcu7t5v0__invz_8 \dstage[5].id.delayenb0  (.EN(\dstage[5].id.ltrimb[0] ),
    .I(\dstage[5].id.ts ),
    .ZN(\dstage[5].id.out ));
 gf180mcu_fd_sc_mcu7t5v0__invz_4 \dstage[5].id.delayenb1  (.EN(\dstage[5].id.ltrimb[1] ),
    .I(\dstage[5].id.ts ),
    .ZN(\dstage[5].id.d1 ));
 gf180mcu_fd_sc_mcu7t5v0__clkinv_2 \dstage[5].id.delayint0  (.I(\dstage[5].id.d1 ),
    .ZN(\dstage[5].id.d2 ));
 gf180mcu_fd_sc_mcu7t5v0__hold \dstage[5].id.hold_d1  (.Z(\dstage[5].id.d1 ));
 gf180mcu_fd_sc_mcu7t5v0__hold \dstage[5].id.hold_out  (.Z(\dstage[5].id.out ));
 gf180mcu_fd_sc_mcu7t5v0__latrnq_1 \dstage[5].id.t0_latch  (.D(trim[5]),
    .E(\dstage[5].id.not_edge ),
    .RN(\dstage[10].id.nreset ),
    .Q(\dstage[5].id.ltrim[0] ));
 gf180mcu_fd_sc_mcu7t5v0__latrnq_1 \dstage[5].id.t1_latch  (.D(trim[18]),
    .E(\dstage[5].id.not_edge ),
    .RN(\dstage[10].id.nreset ),
    .Q(\dstage[5].id.ltrim[1] ));
 gf180mcu_fd_sc_mcu7t5v0__inv_1 \dstage[5].id.trim0bar  (.I(\dstage[5].id.ltrim[0] ),
    .ZN(\dstage[5].id.ltrimb[0] ));
 gf180mcu_fd_sc_mcu7t5v0__inv_1 \dstage[5].id.trim1bar  (.I(\dstage[5].id.ltrim[1] ),
    .ZN(\dstage[5].id.ltrimb[1] ));
 gf180mcu_fd_sc_mcu7t5v0__xor2_1 \dstage[5].id.trim_inhibit  (.A1(\dstage[2].id.out ),
    .A2(\dstage[5].id.out_del ),
    .Z(\dstage[5].id.not_edge ));
 gf180mcu_fd_sc_mcu7t5v0__clkbuf_2 \dstage[6].id.deglitch_buf  (.I(\dstage[6].id.out ),
    .Z(\dstage[6].id.out_del ));
 gf180mcu_fd_sc_mcu7t5v0__clkbuf_2 \dstage[6].id.delaybuf0  (.I(\dstage[5].id.out ),
    .Z(\dstage[6].id.ts ));
 gf180mcu_fd_sc_mcu7t5v0__clkbuf_1 \dstage[6].id.delaybuf1  (.I(\dstage[6].id.ts ),
    .Z(\dstage[6].id.d0 ));
 gf180mcu_fd_sc_mcu7t5v0__invz_2 \dstage[6].id.delayen0  (.EN(\dstage[6].id.ltrim[0] ),
    .I(\dstage[6].id.d2 ),
    .ZN(\dstage[6].id.out ));
 gf180mcu_fd_sc_mcu7t5v0__invz_2 \dstage[6].id.delayen1  (.EN(\dstage[6].id.ltrim[1] ),
    .I(\dstage[6].id.d0 ),
    .ZN(\dstage[6].id.d1 ));
 gf180mcu_fd_sc_mcu7t5v0__invz_8 \dstage[6].id.delayenb0  (.EN(\dstage[6].id.ltrimb[0] ),
    .I(\dstage[6].id.ts ),
    .ZN(\dstage[6].id.out ));
 gf180mcu_fd_sc_mcu7t5v0__invz_4 \dstage[6].id.delayenb1  (.EN(\dstage[6].id.ltrimb[1] ),
    .I(\dstage[6].id.ts ),
    .ZN(\dstage[6].id.d1 ));
 gf180mcu_fd_sc_mcu7t5v0__clkinv_2 \dstage[6].id.delayint0  (.I(\dstage[6].id.d1 ),
    .ZN(\dstage[6].id.d2 ));
 gf180mcu_fd_sc_mcu7t5v0__hold \dstage[6].id.hold_d1  (.Z(\dstage[6].id.d1 ));
 gf180mcu_fd_sc_mcu7t5v0__hold \dstage[6].id.hold_out  (.Z(\dstage[6].id.out ));
 gf180mcu_fd_sc_mcu7t5v0__latrnq_1 \dstage[6].id.t0_latch  (.D(trim[6]),
    .E(\dstage[6].id.not_edge ),
    .RN(\dstage[10].id.nreset ),
    .Q(\dstage[6].id.ltrim[0] ));
 gf180mcu_fd_sc_mcu7t5v0__latrnq_1 \dstage[6].id.t1_latch  (.D(trim[19]),
    .E(\dstage[6].id.not_edge ),
    .RN(\dstage[10].id.nreset ),
    .Q(\dstage[6].id.ltrim[1] ));
 gf180mcu_fd_sc_mcu7t5v0__inv_1 \dstage[6].id.trim0bar  (.I(\dstage[6].id.ltrim[0] ),
    .ZN(\dstage[6].id.ltrimb[0] ));
 gf180mcu_fd_sc_mcu7t5v0__inv_1 \dstage[6].id.trim1bar  (.I(\dstage[6].id.ltrim[1] ),
    .ZN(\dstage[6].id.ltrimb[1] ));
 gf180mcu_fd_sc_mcu7t5v0__xor2_1 \dstage[6].id.trim_inhibit  (.A1(\dstage[3].id.out ),
    .A2(\dstage[6].id.out_del ),
    .Z(\dstage[6].id.not_edge ));
 gf180mcu_fd_sc_mcu7t5v0__clkbuf_2 \dstage[7].id.deglitch_buf  (.I(\dstage[10].id.prev_in ),
    .Z(\dstage[7].id.out_del ));
 gf180mcu_fd_sc_mcu7t5v0__clkbuf_2 \dstage[7].id.delaybuf0  (.I(\dstage[6].id.out ),
    .Z(\dstage[7].id.ts ));
 gf180mcu_fd_sc_mcu7t5v0__clkbuf_1 \dstage[7].id.delaybuf1  (.I(\dstage[7].id.ts ),
    .Z(\dstage[7].id.d0 ));
 gf180mcu_fd_sc_mcu7t5v0__invz_2 \dstage[7].id.delayen0  (.EN(\dstage[7].id.ltrim[0] ),
    .I(\dstage[7].id.d2 ),
    .ZN(\dstage[10].id.prev_in ));
 gf180mcu_fd_sc_mcu7t5v0__invz_2 \dstage[7].id.delayen1  (.EN(\dstage[7].id.ltrim[1] ),
    .I(\dstage[7].id.d0 ),
    .ZN(\dstage[7].id.d1 ));
 gf180mcu_fd_sc_mcu7t5v0__invz_8 \dstage[7].id.delayenb0  (.EN(\dstage[7].id.ltrimb[0] ),
    .I(\dstage[7].id.ts ),
    .ZN(\dstage[10].id.prev_in ));
 gf180mcu_fd_sc_mcu7t5v0__invz_4 \dstage[7].id.delayenb1  (.EN(\dstage[7].id.ltrimb[1] ),
    .I(\dstage[7].id.ts ),
    .ZN(\dstage[7].id.d1 ));
 gf180mcu_fd_sc_mcu7t5v0__clkinv_2 \dstage[7].id.delayint0  (.I(\dstage[7].id.d1 ),
    .ZN(\dstage[7].id.d2 ));
 gf180mcu_fd_sc_mcu7t5v0__hold \dstage[7].id.hold_d1  (.Z(\dstage[7].id.d1 ));
 gf180mcu_fd_sc_mcu7t5v0__hold \dstage[7].id.hold_out  (.Z(\dstage[10].id.prev_in ));
 gf180mcu_fd_sc_mcu7t5v0__latrnq_1 \dstage[7].id.t0_latch  (.D(trim[7]),
    .E(\dstage[7].id.not_edge ),
    .RN(\dstage[10].id.nreset ),
    .Q(\dstage[7].id.ltrim[0] ));
 gf180mcu_fd_sc_mcu7t5v0__latrnq_1 \dstage[7].id.t1_latch  (.D(trim[20]),
    .E(\dstage[7].id.not_edge ),
    .RN(\dstage[10].id.nreset ),
    .Q(\dstage[7].id.ltrim[1] ));
 gf180mcu_fd_sc_mcu7t5v0__inv_1 \dstage[7].id.trim0bar  (.I(\dstage[7].id.ltrim[0] ),
    .ZN(\dstage[7].id.ltrimb[0] ));
 gf180mcu_fd_sc_mcu7t5v0__inv_1 \dstage[7].id.trim1bar  (.I(\dstage[7].id.ltrim[1] ),
    .ZN(\dstage[7].id.ltrimb[1] ));
 gf180mcu_fd_sc_mcu7t5v0__xor2_1 \dstage[7].id.trim_inhibit  (.A1(\dstage[4].id.out ),
    .A2(\dstage[7].id.out_del ),
    .Z(\dstage[7].id.not_edge ));
 gf180mcu_fd_sc_mcu7t5v0__clkbuf_2 \dstage[8].id.deglitch_buf  (.I(\dstage[11].id.prev_in ),
    .Z(\dstage[8].id.out_del ));
 gf180mcu_fd_sc_mcu7t5v0__clkbuf_2 \dstage[8].id.delaybuf0  (.I(\dstage[10].id.prev_in ),
    .Z(\dstage[8].id.ts ));
 gf180mcu_fd_sc_mcu7t5v0__clkbuf_1 \dstage[8].id.delaybuf1  (.I(\dstage[8].id.ts ),
    .Z(\dstage[8].id.d0 ));
 gf180mcu_fd_sc_mcu7t5v0__invz_2 \dstage[8].id.delayen0  (.EN(\dstage[8].id.ltrim[0] ),
    .I(\dstage[8].id.d2 ),
    .ZN(\dstage[11].id.prev_in ));
 gf180mcu_fd_sc_mcu7t5v0__invz_2 \dstage[8].id.delayen1  (.EN(\dstage[8].id.ltrim[1] ),
    .I(\dstage[8].id.d0 ),
    .ZN(\dstage[8].id.d1 ));
 gf180mcu_fd_sc_mcu7t5v0__invz_8 \dstage[8].id.delayenb0  (.EN(\dstage[8].id.ltrimb[0] ),
    .I(\dstage[8].id.ts ),
    .ZN(\dstage[11].id.prev_in ));
 gf180mcu_fd_sc_mcu7t5v0__invz_4 \dstage[8].id.delayenb1  (.EN(\dstage[8].id.ltrimb[1] ),
    .I(\dstage[8].id.ts ),
    .ZN(\dstage[8].id.d1 ));
 gf180mcu_fd_sc_mcu7t5v0__clkinv_2 \dstage[8].id.delayint0  (.I(\dstage[8].id.d1 ),
    .ZN(\dstage[8].id.d2 ));
 gf180mcu_fd_sc_mcu7t5v0__hold \dstage[8].id.hold_d1  (.Z(\dstage[8].id.d1 ));
 gf180mcu_fd_sc_mcu7t5v0__hold \dstage[8].id.hold_out  (.Z(\dstage[11].id.prev_in ));
 gf180mcu_fd_sc_mcu7t5v0__latrnq_1 \dstage[8].id.t0_latch  (.D(trim[8]),
    .E(\dstage[8].id.not_edge ),
    .RN(\dstage[10].id.nreset ),
    .Q(\dstage[8].id.ltrim[0] ));
 gf180mcu_fd_sc_mcu7t5v0__latrnq_1 \dstage[8].id.t1_latch  (.D(trim[21]),
    .E(\dstage[8].id.not_edge ),
    .RN(\dstage[10].id.nreset ),
    .Q(\dstage[8].id.ltrim[1] ));
 gf180mcu_fd_sc_mcu7t5v0__inv_1 \dstage[8].id.trim0bar  (.I(\dstage[8].id.ltrim[0] ),
    .ZN(\dstage[8].id.ltrimb[0] ));
 gf180mcu_fd_sc_mcu7t5v0__inv_1 \dstage[8].id.trim1bar  (.I(\dstage[8].id.ltrim[1] ),
    .ZN(\dstage[8].id.ltrimb[1] ));
 gf180mcu_fd_sc_mcu7t5v0__xor2_1 \dstage[8].id.trim_inhibit  (.A1(\dstage[5].id.out ),
    .A2(\dstage[8].id.out_del ),
    .Z(\dstage[8].id.not_edge ));
 gf180mcu_fd_sc_mcu7t5v0__clkbuf_2 \dstage[9].id.deglitch_buf  (.I(\dstage[10].id.in ),
    .Z(\dstage[9].id.out_del ));
 gf180mcu_fd_sc_mcu7t5v0__clkbuf_2 \dstage[9].id.delaybuf0  (.I(\dstage[11].id.prev_in ),
    .Z(\dstage[9].id.ts ));
 gf180mcu_fd_sc_mcu7t5v0__clkbuf_1 \dstage[9].id.delaybuf1  (.I(\dstage[9].id.ts ),
    .Z(\dstage[9].id.d0 ));
 gf180mcu_fd_sc_mcu7t5v0__invz_2 \dstage[9].id.delayen0  (.EN(\dstage[9].id.ltrim[0] ),
    .I(\dstage[9].id.d2 ),
    .ZN(\dstage[10].id.in ));
 gf180mcu_fd_sc_mcu7t5v0__invz_2 \dstage[9].id.delayen1  (.EN(\dstage[9].id.ltrim[1] ),
    .I(\dstage[9].id.d0 ),
    .ZN(\dstage[9].id.d1 ));
 gf180mcu_fd_sc_mcu7t5v0__invz_8 \dstage[9].id.delayenb0  (.EN(\dstage[9].id.ltrimb[0] ),
    .I(\dstage[9].id.ts ),
    .ZN(\dstage[10].id.in ));
 gf180mcu_fd_sc_mcu7t5v0__invz_4 \dstage[9].id.delayenb1  (.EN(\dstage[9].id.ltrimb[1] ),
    .I(\dstage[9].id.ts ),
    .ZN(\dstage[9].id.d1 ));
 gf180mcu_fd_sc_mcu7t5v0__clkinv_2 \dstage[9].id.delayint0  (.I(\dstage[9].id.d1 ),
    .ZN(\dstage[9].id.d2 ));
 gf180mcu_fd_sc_mcu7t5v0__hold \dstage[9].id.hold_d1  (.Z(\dstage[9].id.d1 ));
 gf180mcu_fd_sc_mcu7t5v0__hold \dstage[9].id.hold_out  (.Z(\dstage[10].id.in ));
 gf180mcu_fd_sc_mcu7t5v0__latrnq_1 \dstage[9].id.t0_latch  (.D(trim[9]),
    .E(\dstage[9].id.not_edge ),
    .RN(\dstage[10].id.nreset ),
    .Q(\dstage[9].id.ltrim[0] ));
 gf180mcu_fd_sc_mcu7t5v0__latrnq_1 \dstage[9].id.t1_latch  (.D(trim[22]),
    .E(\dstage[9].id.not_edge ),
    .RN(\dstage[10].id.nreset ),
    .Q(\dstage[9].id.ltrim[1] ));
 gf180mcu_fd_sc_mcu7t5v0__inv_1 \dstage[9].id.trim0bar  (.I(\dstage[9].id.ltrim[0] ),
    .ZN(\dstage[9].id.ltrimb[0] ));
 gf180mcu_fd_sc_mcu7t5v0__inv_1 \dstage[9].id.trim1bar  (.I(\dstage[9].id.ltrim[1] ),
    .ZN(\dstage[9].id.ltrimb[1] ));
 gf180mcu_fd_sc_mcu7t5v0__xor2_1 \dstage[9].id.trim_inhibit  (.A1(\dstage[6].id.out ),
    .A2(\dstage[9].id.out_del ),
    .Z(\dstage[9].id.not_edge ));
 gf180mcu_fd_sc_mcu7t5v0__clkinv_2 ibufp00 (.I(\dstage[2].id.prev_in ),
    .ZN(\c[0] ));
 gf180mcu_fd_sc_mcu7t5v0__clkinv_8 ibufp01 (.I(\c[0] ),
    .ZN(clockp[0]));
 gf180mcu_fd_sc_mcu7t5v0__clkinv_2 ibufp10 (.I(\dstage[5].id.out ),
    .ZN(\c[1] ));
 gf180mcu_fd_sc_mcu7t5v0__clkinv_8 ibufp11 (.I(\c[1] ),
    .ZN(clockp[1]));
 gf180mcu_fd_sc_mcu7t5v0__clkbuf_2 \id0.deglitch_buf  (.I(\dstage[3].id.prev_in ),
    .Z(\id0.out_del ));
 gf180mcu_fd_sc_mcu7t5v0__clkbuf_2 \id0.delaybuf0  (.I(\dstage[2].id.prev_in ),
    .Z(\id0.ts ));
 gf180mcu_fd_sc_mcu7t5v0__clkbuf_1 \id0.delaybuf1  (.I(\id0.ts ),
    .Z(\id0.d0 ));
 gf180mcu_fd_sc_mcu7t5v0__invz_2 \id0.delayen0  (.EN(\id0.ltrim[0] ),
    .I(\id0.d2 ),
    .ZN(\dstage[3].id.prev_in ));
 gf180mcu_fd_sc_mcu7t5v0__invz_2 \id0.delayen1  (.EN(\id0.ltrim[1] ),
    .I(\id0.d0 ),
    .ZN(\id0.d1 ));
 gf180mcu_fd_sc_mcu7t5v0__invz_8 \id0.delayenb0  (.EN(\id0.ltrimb[0] ),
    .I(\id0.ts ),
    .ZN(\dstage[3].id.prev_in ));
 gf180mcu_fd_sc_mcu7t5v0__invz_4 \id0.delayenb1  (.EN(\id0.ltrimb[1] ),
    .I(\id0.ts ),
    .ZN(\id0.d1 ));
 gf180mcu_fd_sc_mcu7t5v0__clkinv_2 \id0.delayint0  (.I(\id0.d1 ),
    .ZN(\id0.d2 ));
 gf180mcu_fd_sc_mcu7t5v0__hold \id0.hold_d1  (.Z(\id0.d1 ));
 gf180mcu_fd_sc_mcu7t5v0__hold \id0.hold_out  (.Z(\dstage[3].id.prev_in ));
 gf180mcu_fd_sc_mcu7t5v0__latrnq_1 \id0.t0_latch  (.D(trim[0]),
    .E(\id0.not_edge ),
    .RN(\dstage[10].id.nreset ),
    .Q(\id0.ltrim[0] ));
 gf180mcu_fd_sc_mcu7t5v0__latrnq_1 \id0.t1_latch  (.D(trim[13]),
    .E(\id0.not_edge ),
    .RN(\dstage[10].id.nreset ),
    .Q(\id0.ltrim[1] ));
 gf180mcu_fd_sc_mcu7t5v0__inv_1 \id0.trim0bar  (.I(\id0.ltrim[0] ),
    .ZN(\id0.ltrimb[0] ));
 gf180mcu_fd_sc_mcu7t5v0__inv_1 \id0.trim1bar  (.I(\id0.ltrim[1] ),
    .ZN(\id0.ltrimb[1] ));
 gf180mcu_fd_sc_mcu7t5v0__xor2_1 \id0.trim_inhibit  (.A1(\dstage[10].id.out ),
    .A2(\id0.out_del ),
    .Z(\id0.not_edge ));
 gf180mcu_fd_sc_mcu7t5v0__clkbuf_2 \id1.deglitch_buf  (.I(\dstage[2].id.in ),
    .Z(\id1.out_del ));
 gf180mcu_fd_sc_mcu7t5v0__clkbuf_2 \id1.delaybuf0  (.I(\dstage[3].id.prev_in ),
    .Z(\id1.ts ));
 gf180mcu_fd_sc_mcu7t5v0__clkbuf_1 \id1.delaybuf1  (.I(\id1.ts ),
    .Z(\id1.d0 ));
 gf180mcu_fd_sc_mcu7t5v0__invz_2 \id1.delayen0  (.EN(\id1.ltrim[0] ),
    .I(\id1.d2 ),
    .ZN(\dstage[2].id.in ));
 gf180mcu_fd_sc_mcu7t5v0__invz_2 \id1.delayen1  (.EN(\id1.ltrim[1] ),
    .I(\id1.d0 ),
    .ZN(\id1.d1 ));
 gf180mcu_fd_sc_mcu7t5v0__invz_8 \id1.delayenb0  (.EN(\id1.ltrimb[0] ),
    .I(\id1.ts ),
    .ZN(\dstage[2].id.in ));
 gf180mcu_fd_sc_mcu7t5v0__invz_4 \id1.delayenb1  (.EN(\id1.ltrimb[1] ),
    .I(\id1.ts ),
    .ZN(\id1.d1 ));
 gf180mcu_fd_sc_mcu7t5v0__clkinv_2 \id1.delayint0  (.I(\id1.d1 ),
    .ZN(\id1.d2 ));
 gf180mcu_fd_sc_mcu7t5v0__hold \id1.hold_d1  (.Z(\id1.d1 ));
 gf180mcu_fd_sc_mcu7t5v0__hold \id1.hold_out  (.Z(\dstage[2].id.in ));
 gf180mcu_fd_sc_mcu7t5v0__latrnq_1 \id1.t0_latch  (.D(trim[1]),
    .E(\id1.not_edge ),
    .RN(\dstage[10].id.nreset ),
    .Q(\id1.ltrim[0] ));
 gf180mcu_fd_sc_mcu7t5v0__latrnq_1 \id1.t1_latch  (.D(trim[14]),
    .E(\id1.not_edge ),
    .RN(\dstage[10].id.nreset ),
    .Q(\id1.ltrim[1] ));
 gf180mcu_fd_sc_mcu7t5v0__inv_1 \id1.trim0bar  (.I(\id1.ltrim[0] ),
    .ZN(\id1.ltrimb[0] ));
 gf180mcu_fd_sc_mcu7t5v0__inv_1 \id1.trim1bar  (.I(\id1.ltrim[1] ),
    .ZN(\id1.ltrimb[1] ));
 gf180mcu_fd_sc_mcu7t5v0__xor2_1 \id1.trim_inhibit  (.A1(\dstage[11].id.out ),
    .A2(\id1.out_del ),
    .Z(\id1.not_edge ));
 gf180mcu_fd_sc_mcu7t5v0__and2_2 \iss.cg_and  (.A1(\iss.out_precg ),
    .A2(\iss.nreset_del ),
    .Z(\dstage[2].id.prev_in ));
 gf180mcu_fd_sc_mcu7t5v0__antenna \ANTENNA_iss.reseten0_EN  (.I(reset));
 gf180mcu_fd_sc_mcu7t5v0__nor2_2 \iss.ctrlen0  (.A1(reset),
    .A2(\iss.ltrim[0] ),
    .ZN(\iss.ctrl0b ));
 gf180mcu_fd_sc_mcu7t5v0__clkbuf_2 \iss.deglitch_buf  (.I(\dstage[2].id.prev_in ),
    .Z(\iss.out_del ));
 gf180mcu_fd_sc_mcu7t5v0__clkbuf_1 \iss.delaybuf0  (.I(\dstage[11].id.out ),
    .Z(\iss.d0 ));
 gf180mcu_fd_sc_mcu7t5v0__invz_2 \iss.delayen0  (.EN(\iss.ltrim[0] ),
    .I(\iss.d2 ),
    .ZN(\iss.out_precg ));
 gf180mcu_fd_sc_mcu7t5v0__invz_2 \iss.delayen1  (.EN(\iss.ltrim[1] ),
    .I(\iss.d0 ),
    .ZN(\iss.d1 ));
 gf180mcu_fd_sc_mcu7t5v0__invz_8 \iss.delayenb0  (.EN(\iss.ctrl0b ),
    .I(\dstage[11].id.out ),
    .ZN(\iss.out_precg ));
 gf180mcu_fd_sc_mcu7t5v0__invz_4 \iss.delayenb1  (.EN(\iss.trim1b ),
    .I(\dstage[11].id.out ),
    .ZN(\iss.d1 ));
 gf180mcu_fd_sc_mcu7t5v0__clkinv_1 \iss.delayint0  (.I(\iss.d1 ),
    .ZN(\iss.d2 ));
 gf180mcu_fd_sc_mcu7t5v0__hold \iss.hold_d1  (.Z(\iss.d1 ));
 gf180mcu_fd_sc_mcu7t5v0__hold \iss.hold_out  (.Z(\iss.out_precg ));
 gf180mcu_fd_sc_mcu7t5v0__dlyb_1 \iss.nreset_delay  (.I(\dstage[10].id.nreset ),
    .Z(\iss.nreset_del ));
 gf180mcu_fd_sc_mcu7t5v0__invz_1 \iss.reseten0  (.EN(reset),
    .I(net),
    .ZN(\iss.out_precg ));
 gf180mcu_fd_sc_mcu7t5v0__latrnq_1 \iss.t0_latch  (.D(trim[12]),
    .E(\iss.not_edge ),
    .RN(\dstage[10].id.nreset ),
    .Q(\iss.ltrim[0] ));
 gf180mcu_fd_sc_mcu7t5v0__latrnq_1 \iss.t1_latch  (.D(trim[25]),
    .E(\iss.not_edge ),
    .RN(\dstage[10].id.nreset ),
    .Q(\iss.ltrim[1] ));
 gf180mcu_fd_sc_mcu7t5v0__inv_2 \iss.trim1bar  (.I(\iss.ltrim[1] ),
    .ZN(\iss.trim1b ));
 gf180mcu_fd_sc_mcu7t5v0__xor2_1 \iss.trim_inhibit  (.A1(\dstage[10].id.in ),
    .A2(\iss.out_del ),
    .Z(\iss.not_edge ));
 gf180mcu_fd_sc_mcu7t5v0__endcap PHY_EDGE_ROW_0_Right_0 ();
 gf180mcu_fd_sc_mcu7t5v0__endcap PHY_EDGE_ROW_1_Right_1 ();
 gf180mcu_fd_sc_mcu7t5v0__endcap PHY_EDGE_ROW_2_Right_2 ();
 gf180mcu_fd_sc_mcu7t5v0__endcap PHY_EDGE_ROW_3_Right_3 ();
 gf180mcu_fd_sc_mcu7t5v0__endcap PHY_EDGE_ROW_4_Right_4 ();
 gf180mcu_fd_sc_mcu7t5v0__endcap PHY_EDGE_ROW_5_Right_5 ();
 gf180mcu_fd_sc_mcu7t5v0__endcap PHY_EDGE_ROW_6_Right_6 ();
 gf180mcu_fd_sc_mcu7t5v0__endcap PHY_EDGE_ROW_7_Right_7 ();
 gf180mcu_fd_sc_mcu7t5v0__endcap PHY_EDGE_ROW_8_Right_8 ();
 gf180mcu_fd_sc_mcu7t5v0__endcap PHY_EDGE_ROW_9_Right_9 ();
 gf180mcu_fd_sc_mcu7t5v0__endcap PHY_EDGE_ROW_10_Right_10 ();
 gf180mcu_fd_sc_mcu7t5v0__endcap PHY_EDGE_ROW_11_Right_11 ();
 gf180mcu_fd_sc_mcu7t5v0__endcap PHY_EDGE_ROW_12_Right_12 ();
 gf180mcu_fd_sc_mcu7t5v0__endcap PHY_EDGE_ROW_13_Right_13 ();
 gf180mcu_fd_sc_mcu7t5v0__endcap PHY_EDGE_ROW_14_Right_14 ();
 gf180mcu_fd_sc_mcu7t5v0__endcap PHY_EDGE_ROW_15_Right_15 ();
 gf180mcu_fd_sc_mcu7t5v0__endcap PHY_EDGE_ROW_16_Right_16 ();
 gf180mcu_fd_sc_mcu7t5v0__endcap PHY_EDGE_ROW_17_Right_17 ();
 gf180mcu_fd_sc_mcu7t5v0__endcap PHY_EDGE_ROW_18_Right_18 ();
 gf180mcu_fd_sc_mcu7t5v0__endcap PHY_EDGE_ROW_19_Right_19 ();
 gf180mcu_fd_sc_mcu7t5v0__endcap PHY_EDGE_ROW_20_Right_20 ();
 gf180mcu_fd_sc_mcu7t5v0__endcap PHY_EDGE_ROW_21_Right_21 ();
 gf180mcu_fd_sc_mcu7t5v0__endcap PHY_EDGE_ROW_0_Left_22 ();
 gf180mcu_fd_sc_mcu7t5v0__endcap PHY_EDGE_ROW_1_Left_23 ();
 gf180mcu_fd_sc_mcu7t5v0__endcap PHY_EDGE_ROW_2_Left_24 ();
 gf180mcu_fd_sc_mcu7t5v0__endcap PHY_EDGE_ROW_3_Left_25 ();
 gf180mcu_fd_sc_mcu7t5v0__endcap PHY_EDGE_ROW_4_Left_26 ();
 gf180mcu_fd_sc_mcu7t5v0__endcap PHY_EDGE_ROW_5_Left_27 ();
 gf180mcu_fd_sc_mcu7t5v0__endcap PHY_EDGE_ROW_6_Left_28 ();
 gf180mcu_fd_sc_mcu7t5v0__endcap PHY_EDGE_ROW_7_Left_29 ();
 gf180mcu_fd_sc_mcu7t5v0__endcap PHY_EDGE_ROW_8_Left_30 ();
 gf180mcu_fd_sc_mcu7t5v0__endcap PHY_EDGE_ROW_9_Left_31 ();
 gf180mcu_fd_sc_mcu7t5v0__endcap PHY_EDGE_ROW_10_Left_32 ();
 gf180mcu_fd_sc_mcu7t5v0__endcap PHY_EDGE_ROW_11_Left_33 ();
 gf180mcu_fd_sc_mcu7t5v0__endcap PHY_EDGE_ROW_12_Left_34 ();
 gf180mcu_fd_sc_mcu7t5v0__endcap PHY_EDGE_ROW_13_Left_35 ();
 gf180mcu_fd_sc_mcu7t5v0__endcap PHY_EDGE_ROW_14_Left_36 ();
 gf180mcu_fd_sc_mcu7t5v0__endcap PHY_EDGE_ROW_15_Left_37 ();
 gf180mcu_fd_sc_mcu7t5v0__endcap PHY_EDGE_ROW_16_Left_38 ();
 gf180mcu_fd_sc_mcu7t5v0__endcap PHY_EDGE_ROW_17_Left_39 ();
 gf180mcu_fd_sc_mcu7t5v0__endcap PHY_EDGE_ROW_18_Left_40 ();
 gf180mcu_fd_sc_mcu7t5v0__endcap PHY_EDGE_ROW_19_Left_41 ();
 gf180mcu_fd_sc_mcu7t5v0__endcap PHY_EDGE_ROW_20_Left_42 ();
 gf180mcu_fd_sc_mcu7t5v0__endcap PHY_EDGE_ROW_21_Left_43 ();
 gf180mcu_fd_sc_mcu7t5v0__filltie TAP_TAPCELL_ROW_0_44 ();
 gf180mcu_fd_sc_mcu7t5v0__filltie TAP_TAPCELL_ROW_0_45 ();
 gf180mcu_fd_sc_mcu7t5v0__filltie TAP_TAPCELL_ROW_0_46 ();
 gf180mcu_fd_sc_mcu7t5v0__filltie TAP_TAPCELL_ROW_0_47 ();
 gf180mcu_fd_sc_mcu7t5v0__filltie TAP_TAPCELL_ROW_1_48 ();
 gf180mcu_fd_sc_mcu7t5v0__filltie TAP_TAPCELL_ROW_1_49 ();
 gf180mcu_fd_sc_mcu7t5v0__filltie TAP_TAPCELL_ROW_2_50 ();
 gf180mcu_fd_sc_mcu7t5v0__filltie TAP_TAPCELL_ROW_2_51 ();
 gf180mcu_fd_sc_mcu7t5v0__filltie TAP_TAPCELL_ROW_3_52 ();
 gf180mcu_fd_sc_mcu7t5v0__filltie TAP_TAPCELL_ROW_3_53 ();
 gf180mcu_fd_sc_mcu7t5v0__filltie TAP_TAPCELL_ROW_4_54 ();
 gf180mcu_fd_sc_mcu7t5v0__filltie TAP_TAPCELL_ROW_4_55 ();
 gf180mcu_fd_sc_mcu7t5v0__filltie TAP_TAPCELL_ROW_5_56 ();
 gf180mcu_fd_sc_mcu7t5v0__filltie TAP_TAPCELL_ROW_5_57 ();
 gf180mcu_fd_sc_mcu7t5v0__filltie TAP_TAPCELL_ROW_6_58 ();
 gf180mcu_fd_sc_mcu7t5v0__filltie TAP_TAPCELL_ROW_6_59 ();
 gf180mcu_fd_sc_mcu7t5v0__filltie TAP_TAPCELL_ROW_7_60 ();
 gf180mcu_fd_sc_mcu7t5v0__filltie TAP_TAPCELL_ROW_7_61 ();
 gf180mcu_fd_sc_mcu7t5v0__filltie TAP_TAPCELL_ROW_8_62 ();
 gf180mcu_fd_sc_mcu7t5v0__filltie TAP_TAPCELL_ROW_8_63 ();
 gf180mcu_fd_sc_mcu7t5v0__filltie TAP_TAPCELL_ROW_9_64 ();
 gf180mcu_fd_sc_mcu7t5v0__filltie TAP_TAPCELL_ROW_9_65 ();
 gf180mcu_fd_sc_mcu7t5v0__filltie TAP_TAPCELL_ROW_10_66 ();
 gf180mcu_fd_sc_mcu7t5v0__filltie TAP_TAPCELL_ROW_10_67 ();
 gf180mcu_fd_sc_mcu7t5v0__filltie TAP_TAPCELL_ROW_11_68 ();
 gf180mcu_fd_sc_mcu7t5v0__filltie TAP_TAPCELL_ROW_11_69 ();
 gf180mcu_fd_sc_mcu7t5v0__filltie TAP_TAPCELL_ROW_12_70 ();
 gf180mcu_fd_sc_mcu7t5v0__filltie TAP_TAPCELL_ROW_12_71 ();
 gf180mcu_fd_sc_mcu7t5v0__filltie TAP_TAPCELL_ROW_13_72 ();
 gf180mcu_fd_sc_mcu7t5v0__filltie TAP_TAPCELL_ROW_13_73 ();
 gf180mcu_fd_sc_mcu7t5v0__filltie TAP_TAPCELL_ROW_14_74 ();
 gf180mcu_fd_sc_mcu7t5v0__filltie TAP_TAPCELL_ROW_14_75 ();
 gf180mcu_fd_sc_mcu7t5v0__filltie TAP_TAPCELL_ROW_15_76 ();
 gf180mcu_fd_sc_mcu7t5v0__filltie TAP_TAPCELL_ROW_15_77 ();
 gf180mcu_fd_sc_mcu7t5v0__filltie TAP_TAPCELL_ROW_16_78 ();
 gf180mcu_fd_sc_mcu7t5v0__filltie TAP_TAPCELL_ROW_16_79 ();
 gf180mcu_fd_sc_mcu7t5v0__filltie TAP_TAPCELL_ROW_17_80 ();
 gf180mcu_fd_sc_mcu7t5v0__filltie TAP_TAPCELL_ROW_17_81 ();
 gf180mcu_fd_sc_mcu7t5v0__filltie TAP_TAPCELL_ROW_18_82 ();
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
 gf180mcu_fd_sc_mcu7t5v0__fill_1 FILLER_21_84 ();
 gf180mcu_fd_sc_mcu7t5v0__fillcap_8 FILLER_21_125 ();
 gf180mcu_fd_sc_mcu7t5v0__fill_2 FILLER_21_133 ();
 gf180mcu_fd_sc_mcu7t5v0__fill_1 FILLER_21_135 ();
 gf180mcu_fd_sc_mcu7t5v0__fillcap_16 FILLER_21_138 ();
endmodule
