ZeduloTech/gf180mcu-testchip2025/caravel/ring_osc2x13/final/pnl/ring_osc2x13.pnl.v

module ring_osc2x13 (reset,
    VDD,
    VSS,
    clockp,
    trim);
 input reset;
 inout VDD;
 inout VSS;
 output [1:0] clockp;
 input [25:0] trim;

 wire \c[0] ;
 wire \c[1] ;
 wire \dstage[10].id.d0 ;
 wire \dstage[10].id.d1 ;
 wire \dstage[10].id.d2 ;
 wire \dstage[10].id.in ;
 wire \dstage[10].id.ltrim[0] ;
 wire \dstage[10].id.ltrim[1] ;
 wire \dstage[10].id.ltrimb[0] ;
 wire \dstage[10].id.ltrimb[1] ;
 wire \dstage[10].id.not_edge ;
 wire \dstage[10].id.nreset ;
 wire \dstage[10].id.out ;
 wire \dstage[10].id.out_del ;
 wire \dstage[10].id.prev_in ;
 wire \dstage[10].id.ts ;
 wire \dstage[11].id.d0 ;
 wire \dstage[11].id.d1 ;
 wire \dstage[11].id.d2 ;
 wire \dstage[11].id.ltrim[0] ;
 wire \dstage[11].id.ltrim[1] ;
 wire \dstage[11].id.ltrimb[0] ;
 wire \dstage[11].id.ltrimb[1] ;
 wire \dstage[11].id.not_edge ;
 wire \dstage[11].id.out ;
 wire \dstage[11].id.out_del ;
 wire \dstage[11].id.prev_in ;
 wire \dstage[11].id.ts ;
 wire \dstage[2].id.d0 ;
 wire \dstage[2].id.d1 ;
 wire \dstage[2].id.d2 ;
 wire \dstage[2].id.in ;
 wire \dstage[2].id.ltrim[0] ;
 wire \dstage[2].id.ltrim[1] ;
 wire \dstage[2].id.ltrimb[0] ;
 wire \dstage[2].id.ltrimb[1] ;
 wire \dstage[2].id.not_edge ;
 wire \dstage[2].id.out ;
 wire \dstage[2].id.out_del ;
 wire \dstage[2].id.prev_in ;
 wire \dstage[2].id.ts ;
 wire \dstage[3].id.d0 ;
 wire \dstage[3].id.d1 ;
 wire \dstage[3].id.d2 ;
 wire \dstage[3].id.ltrim[0] ;
 wire \dstage[3].id.ltrim[1] ;
 wire \dstage[3].id.ltrimb[0] ;
 wire \dstage[3].id.ltrimb[1] ;
 wire \dstage[3].id.not_edge ;
 wire \dstage[3].id.out ;
 wire \dstage[3].id.out_del ;
 wire \dstage[3].id.prev_in ;
 wire \dstage[3].id.ts ;
 wire \dstage[4].id.d0 ;
 wire \dstage[4].id.d1 ;
 wire \dstage[4].id.d2 ;
 wire \dstage[4].id.ltrim[0] ;
 wire \dstage[4].id.ltrim[1] ;
 wire \dstage[4].id.ltrimb[0] ;
 wire \dstage[4].id.ltrimb[1] ;
 wire \dstage[4].id.not_edge ;
 wire \dstage[4].id.out ;
 wire \dstage[4].id.out_del ;
 wire \dstage[4].id.ts ;
 wire \dstage[5].id.d0 ;
 wire \dstage[5].id.d1 ;
 wire \dstage[5].id.d2 ;
 wire \dstage[5].id.ltrim[0] ;
 wire \dstage[5].id.ltrim[1] ;
 wire \dstage[5].id.ltrimb[0] ;
 wire \dstage[5].id.ltrimb[1] ;
 wire \dstage[5].id.not_edge ;
 wire \dstage[5].id.out ;
 wire \dstage[5].id.out_del ;
 wire \dstage[5].id.ts ;
 wire \dstage[6].id.d0 ;
 wire \dstage[6].id.d1 ;
 wire \dstage[6].id.d2 ;
 wire \dstage[6].id.ltrim[0] ;
 wire \dstage[6].id.ltrim[1] ;
 wire \dstage[6].id.ltrimb[0] ;
 wire \dstage[6].id.ltrimb[1] ;
 wire \dstage[6].id.not_edge ;
 wire \dstage[6].id.out ;
 wire \dstage[6].id.out_del ;
 wire \dstage[6].id.ts ;
 wire \dstage[7].id.d0 ;
 wire \dstage[7].id.d1 ;
 wire \dstage[7].id.d2 ;
 wire \dstage[7].id.ltrim[0] ;
 wire \dstage[7].id.ltrim[1] ;
 wire \dstage[7].id.ltrimb[0] ;
 wire \dstage[7].id.ltrimb[1] ;
 wire \dstage[7].id.not_edge ;
 wire \dstage[7].id.out_del ;
 wire \dstage[7].id.ts ;
 wire \dstage[8].id.d0 ;
 wire \dstage[8].id.d1 ;
 wire \dstage[8].id.d2 ;
 wire \dstage[8].id.ltrim[0] ;
 wire \dstage[8].id.ltrim[1] ;
 wire \dstage[8].id.ltrimb[0] ;
 wire \dstage[8].id.ltrimb[1] ;
 wire \dstage[8].id.not_edge ;
 wire \dstage[8].id.out_del ;
 wire \dstage[8].id.ts ;
 wire \dstage[9].id.d0 ;
 wire \dstage[9].id.d1 ;
 wire \dstage[9].id.d2 ;
 wire \dstage[9].id.ltrim[0] ;
 wire \dstage[9].id.ltrim[1] ;
 wire \dstage[9].id.ltrimb[0] ;
 wire \dstage[9].id.ltrimb[1] ;
 wire \dstage[9].id.not_edge ;
 wire \dstage[9].id.out_del ;
 wire \dstage[9].id.ts ;
 wire \id0.d0 ;
 wire \id0.d1 ;
 wire \id0.d2 ;
 wire \id0.ltrim[0] ;
 wire \id0.ltrim[1] ;
 wire \id0.ltrimb[0] ;
 wire \id0.ltrimb[1] ;
 wire \id0.not_edge ;
 wire \id0.out_del ;
 wire \id0.ts ;
 wire \id1.d0 ;
 wire \id1.d1 ;
 wire \id1.d2 ;
 wire \id1.ltrim[0] ;
 wire \id1.ltrim[1] ;
 wire \id1.ltrimb[0] ;
 wire \id1.ltrimb[1] ;
 wire \id1.not_edge ;
 wire \id1.out_del ;
 wire \id1.ts ;
 wire \iss.ctrl0b ;
 wire \iss.d0 ;
 wire \iss.d1 ;
 wire \iss.d2 ;
 wire \iss.ltrim[0] ;
 wire \iss.ltrim[1] ;
 wire \iss.not_edge ;
 wire \iss.nreset_del ;
 wire \iss.out_del ;
 wire \iss.out_precg ;
 wire \iss.trim1b ;
 wire net;

 gf180mcu_fd_sc_mcu7t5v0__clkinv_1 _0_ (.I(reset),
    .ZN(\dstage[10].id.nreset ),
    .VDD(VDD),
    .VNW(VDD),
    .VPW(VSS),
    .VSS(VSS));
 gf180mcu_fd_sc_mcu7t5v0__clkbuf_2 \dstage[10].id.deglitch_buf  (.I(\dstage[10].id.out ),
    .Z(\dstage[10].id.out_del ),
    .VDD(VDD),
    .VNW(VDD),
    .VPW(VSS),
    .VSS(VSS));
 gf180mcu_fd_sc_mcu7t5v0__clkbuf_2 \dstage[10].id.delaybuf0  (.I(\dstage[10].id.in ),
    .Z(\dstage[10].id.ts ),
    .VDD(VDD),
    .VNW(VDD),
    .VPW(VSS),
    .VSS(VSS));
 gf180mcu_fd_sc_mcu7t5v0__clkbuf_1 \dstage[10].id.delaybuf1  (.I(\dstage[10].id.ts ),
    .Z(\dstage[10].id.d0 ),
    .VDD(VDD),
    .VNW(VDD),
    .VPW(VSS),
    .VSS(VSS));
 gf180mcu_fd_sc_mcu7t5v0__invz_2 \dstage[10].id.delayen0  (.EN(\dstage[10].id.ltrim[0] ),
    .I(\dstage[10].id.d2 ),
    .ZN(\dstage[10].id.out ),
    .VDD(VDD),
    .VNW(VDD),
    .VPW(VSS),
    .VSS(VSS));
 gf180mcu_fd_sc_mcu7t5v0__invz_2 \dstage[10].id.delayen1  (.EN(\dstage[10].id.ltrim[1] ),
    .I(\dstage[10].id.d0 ),
    .ZN(\dstage[10].id.d1 ),
    .VDD(VDD),
    .VNW(VDD),
    .VPW(VSS),
    .VSS(VSS));
 gf180mcu_fd_sc_mcu7t5v0__invz_8 \dstage[10].id.delayenb0  (.EN(\dstage[10].id.ltrimb[0] ),
    .I(\dstage[10].id.ts ),
    .ZN(\dstage[10].id.out ),
    .VDD(VDD),
    .VNW(VDD),
    .VPW(VSS),
    .VSS(VSS));
 gf180mcu_fd_sc_mcu7t5v0__invz_4 \dstage[10].id.delayenb1  (.EN(\dstage[10].id.ltrimb[1] ),
    .I(\dstage[10].id.ts ),
    .ZN(\dstage[10].id.d1 ),
    .VDD(VDD),
    .VNW(VDD),
    .VPW(VSS),
    .VSS(VSS));
 gf180mcu_fd_sc_mcu7t5v0__clkinv_2 \dstage[10].id.delayint0  (.I(\dstage[10].id.d1 ),
    .ZN(\dstage[10].id.d2 ),
    .VDD(VDD),
    .VNW(VDD),
    .VPW(VSS),
    .VSS(VSS));
 gf180mcu_fd_sc_mcu7t5v0__hold \dstage[10].id.hold_d1  (.Z(\dstage[10].id.d1 ),
    .VDD(VDD),
    .VNW(VDD),
    .VPW(VSS),
    .VSS(VSS));
 gf180mcu_fd_sc_mcu7t5v0__hold \dstage[10].id.hold_out  (.Z(\dstage[10].id.out ),
    .VDD(VDD),
    .VNW(VDD),
    .VPW(VSS),
    .VSS(VSS));
 gf180mcu_fd_sc_mcu7t5v0__latrnq_1 \dstage[10].id.t0_latch  (.D(trim[10]),
    .E(\dstage[10].id.not_edge ),
    .RN(\dstage[10].id.nreset ),
    .Q(\dstage[10].id.ltrim[0] ),
    .VDD(VDD),
    .VNW(VDD),
    .VPW(VSS),
    .VSS(VSS));
 gf180mcu_fd_sc_mcu7t5v0__latrnq_1 \dstage[10].id.t1_latch  (.D(trim[23]),
    .E(\dstage[10].id.not_edge ),
    .RN(\dstage[10].id.nreset ),
    .Q(\dstage[10].id.ltrim[1] ),
    .VDD(VDD),
    .VNW(VDD),
    .VPW(VSS),
    .VSS(VSS));
 gf180mcu_fd_sc_mcu7t5v0__inv_1 \dstage[10].id.trim0bar  (.I(\dstage[10].id.ltrim[0] ),
    .ZN(\dstage[10].id.ltrimb[0] ),
    .VDD(VDD),
    .VNW(VDD),
    .VPW(VSS),
    .VSS(VSS));
 gf180mcu_fd_sc_mcu7t5v0__inv_1 \dstage[10].id.trim1bar  (.I(\dstage[10].id.ltrim[1] ),
    .ZN(\dstage[10].id.ltrimb[1] ),
    .VDD(VDD),
    .VNW(VDD),
    .VPW(VSS),
    .VSS(VSS));
 gf180mcu_fd_sc_mcu7t5v0__xor2_1 \dstage[10].id.trim_inhibit  (.A1(\dstage[10].id.prev_in ),
    .A2(\dstage[10].id.out_del ),
    .Z(\dstage[10].id.not_edge ),
    .VDD(VDD),
    .VNW(VDD),
    .VPW(VSS),
    .VSS(VSS));
 gf180mcu_fd_sc_mcu7t5v0__clkbuf_2 \dstage[11].id.deglitch_buf  (.I(\dstage[11].id.out ),
    .Z(\dstage[11].id.out_del ),
    .VDD(VDD),
    .VNW(VDD),
    .VPW(VSS),
    .VSS(VSS));
 gf180mcu_fd_sc_mcu7t5v0__clkbuf_2 \dstage[11].id.delaybuf0  (.I(\dstage[10].id.out ),
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
    .A2(\iss.nreset_del ),
    .Z(\dstage[2].id.prev_in ),
    .VDD(VDD),
    .VNW(VDD),
    .VPW(VSS),
    .VSS(VSS));
 gf180mcu_fd_sc_mcu7t5v0__antenna \ANTENNA_iss.reseten0_EN  (.I(reset),
    .VDD(VDD),
    .VNW(VDD),
    .VPW(VSS),
    .VSS(VSS));
 gf180mcu_fd_sc_mcu7t5v0__nor2_2 \iss.ctrlen0  (.A1(reset),
    .A2(\iss.ltrim[0] ),
    .ZN(\iss.ctrl0b ),
    .VDD(VDD),
    .VNW(VDD),
    .VPW(VSS),
    .VSS(VSS));
 gf180mcu_fd_sc_mcu7t5v0__clkbuf_2 \iss.deglitch_buf  (.I(\dstage[2].id.prev_in ),
    .Z(\iss.out_del ),
    .VDD(VDD),
    .VNW(VDD),
    .VPW(VSS),
    .VSS(VSS));
 gf180mcu_fd_sc_mcu7t5v0__clkbuf_1 \iss.delaybuf0  (.I(\dstage[11].id.out ),
    .Z(\iss.d0 ),
    .VDD(VDD),
    .VNW(VDD),
    .VPW(VSS),
    .VSS(VSS));
 gf180mcu_fd_sc_mcu7t5v0__invz_2 \iss.delayen0  (.EN(\iss.ltrim[0] ),
    .I(\iss.d2 ),
    .ZN(\iss.out_precg ),
    .VDD(VDD),
    .VNW(VDD),
    .VPW(VSS),
    .VSS(VSS));
 gf180mcu_fd_sc_mcu7t5v0__invz_2 \iss.delayen1  (.EN(\iss.ltrim[1] ),
    .I(\iss.d0 ),
    .ZN(\iss.d1 ),
    .VDD(VDD),
    .VNW(VDD),
    .VPW(VSS),
    .VSS(VSS));
 gf180mcu_fd_sc_mcu7t5v0__invz_8 \iss.delayenb0  (.EN(\iss.ctrl0b ),
    .I(\dstage[11].id.out ),
    .ZN(\iss.out_precg ),
    .VDD(VDD),
    .VNW(VDD),
    .VPW(VSS),
    .VSS(VSS));
 gf180mcu_fd_sc_mcu7t5v0__invz_4 \iss.delayenb1  (.EN(\iss.trim1b ),
    .I(\dstage[11].id.out ),
    .ZN(\iss.d1 ),
    .VDD(VDD),
    .VNW(VDD),
    .VPW(VSS),
    .VSS(VSS));
 gf180mcu_fd_sc_mcu7t5v0__clkinv_1 \iss.delayint0  (.I(\iss.d1 ),
    .ZN(\iss.d2 ),
    .VDD(VDD),
    .VNW(VDD),
    .VPW(VSS),
    .VSS(VSS));
 gf180mcu_fd_sc_mcu7t5v0__hold \iss.hold_d1  (.Z(\iss.d1 ),
    .VDD(VDD),
    .VNW(VDD),
    .VPW(VSS),
    .VSS(VSS));
 gf180mcu_fd_sc_mcu7t5v0__hold \iss.hold_out  (.Z(\iss.out_precg ),
    .VDD(VDD),
    .VNW(VDD),
    .VPW(VSS),
    .VSS(VSS));
 gf180mcu_fd_sc_mcu7t5v0__dlyb_1 \iss.nreset_delay  (.I(\dstage[10].id.nreset ),
    .Z(\iss.nreset_del ),
    .VDD(VDD),
    .VNW(VDD),
    .VPW(VSS),
    .VSS(VSS));
 gf180mcu_fd_sc_mcu7t5v0__invz_1 \iss.reseten0  (.EN(reset),
    .I(net),
    .ZN(\iss.out_precg ),
    .VDD(VDD),
    .VNW(VDD),
    .VPW(VSS),
    .VSS(VSS));
 gf180mcu_fd_sc_mcu7t5v0__latrnq_1 \iss.t0_latch  (.D(trim[12]),
    .E(\iss.not_edge ),
    .RN(\dstage[10].id.nreset ),
    .Q(\iss.ltrim[0] ),
    .VDD(VDD),
    .VNW(VDD),
    .VPW(VSS),
    .VSS(VSS));
 gf180mcu_fd_sc_mcu7t5v0__latrnq_1 \iss.t1_latch  (.D(trim[25]),
    .E(\iss.not_edge ),
    .RN(\dstage[10].id.nreset ),
    .Q(\iss.ltrim[1] ),
    .VDD(VDD),
    .VNW(VDD),
    .VPW(VSS),
    .VSS(VSS));
 gf180mcu_fd_sc_mcu7t5v0__inv_2 \iss.trim1bar  (.I(\iss.ltrim[1] ),
    .ZN(\iss.trim1b ),
    .VDD(VDD),
    .VNW(VDD),
    .VPW(VSS),
    .VSS(VSS));
 gf180mcu_fd_sc_mcu7t5v0__xor2_1 \iss.trim_inhibit  (.A1(\dstage[10].id.in ),
    .A2(\iss.out_del ),
    .Z(\iss.not_edge ),
    .VDD(VDD),
    .VNW(VDD),
    .VPW(VSS),
    .VSS(VSS));
 gf180mcu_fd_sc_mcu7t5v0__endcap PHY_EDGE_ROW_0_Right_0 (.VDD(VDD),
    .VSS(VSS));
 gf180mcu_fd_sc_mcu7t5v0__endcap PHY_EDGE_ROW_1_Right_1 (.VDD(VDD),
    .VSS(VSS));
 gf180mcu_fd_sc_mcu7t5v0__endcap PHY_EDGE_ROW_2_Right_2 (.VDD(VDD),
    .VSS(VSS));
 gf180mcu_fd_sc_mcu7t5v0__endcap PHY_EDGE_ROW_3_Right_3 (.VDD(VDD),
    .VSS(VSS));
 gf180mcu_fd_sc_mcu7t5v0__endcap PHY_EDGE_ROW_4_Right_4 (.VDD(VDD),
    .VSS(VSS));
 gf180mcu_fd_sc_mcu7t5v0__endcap PHY_EDGE_ROW_5_Right_5 (.VDD(VDD),
    .VSS(VSS));
 gf180mcu_fd_sc_mcu7t5v0__endcap PHY_EDGE_ROW_6_Right_6 (.VDD(VDD),
    .VSS(VSS));
 gf180mcu_fd_sc_mcu7t5v0__endcap PHY_EDGE_ROW_7_Right_7 (.VDD(VDD),
    .VSS(VSS));
 gf180mcu_fd_sc_mcu7t5v0__endcap PHY_EDGE_ROW_8_Right_8 (.VDD(VDD),
    .VSS(VSS));
 gf180mcu_fd_sc_mcu7t5v0__endcap PHY_EDGE_ROW_9_Right_9 (.VDD(VDD),
    .VSS(VSS));
 gf180mcu_fd_sc_mcu7t5v0__endcap PHY_EDGE_ROW_10_Right_10 (.VDD(VDD),
    .VSS(VSS));
 gf180mcu_fd_sc_mcu7t5v0__endcap PHY_EDGE_ROW_11_Right_11 (.VDD(VDD),
    .VSS(VSS));
 gf180mcu_fd_sc_mcu7t5v0__endcap PHY_EDGE_ROW_12_Right_12 (.VDD(VDD),
    .VSS(VSS));
 gf180mcu_fd_sc_mcu7t5v0__endcap PHY_EDGE_ROW_13_Right_13 (.VDD(VDD),
    .VSS(VSS));
 gf180mcu_fd_sc_mcu7t5v0__endcap PHY_EDGE_ROW_14_Right_14 (.VDD(VDD),
    .VSS(VSS));
 gf180mcu_fd_sc_mcu7t5v0__endcap PHY_EDGE_ROW_15_Right_15 (.VDD(VDD),
    .VSS(VSS));
 gf180mcu_fd_sc_mcu7t5v0__endcap PHY_EDGE_ROW_16_Right_16 (.VDD(VDD),
    .VSS(VSS));
 gf180mcu_fd_sc_mcu7t5v0__endcap PHY_EDGE_ROW_17_Right_17 (.VDD(VDD),
    .VSS(VSS));
 gf180mcu_fd_sc_mcu7t5v0__endcap PHY_EDGE_ROW_18_Right_18 (.VDD(VDD),
    .VSS(VSS));
 gf180mcu_fd_sc_mcu7t5v0__endcap PHY_EDGE_ROW_19_Right_19 (.VDD(VDD),
    .VSS(VSS));
 gf180mcu_fd_sc_mcu7t5v0__endcap PHY_EDGE_ROW_20_Right_20 (.VDD(VDD),
    .VSS(VSS));
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
    .VNW(VDD),
    .VPW(VSS),
    .VSS(VSS));
 gf180mcu_fd_sc_mcu7t5v0__fill_1 FILLER_21_84 (.VDD(VDD),
    .VNW(VDD),
    .VPW(VSS),
    .VSS(VSS));
 gf180mcu_fd_sc_mcu7t5v0__fillcap_8 FILLER_21_125 (.VDD(VDD),
    .VNW(VDD),
    .VPW(VSS),
    .VSS(VSS));
 gf180mcu_fd_sc_mcu7t5v0__fill_2 FILLER_21_133 (.VDD(VDD),
    .VNW(VDD),
    .VPW(VSS),
    .VSS(VSS));
 gf180mcu_fd_sc_mcu7t5v0__fill_1 FILLER_21_135 (.VDD(VDD),
    .VNW(VDD),
    .VPW(VSS),
    .VSS(VSS));
 gf180mcu_fd_sc_mcu7t5v0__fillcap_16 FILLER_21_138 (.VDD(VDD),
    .VNW(VDD),
    .VPW(VSS),
    .VSS(VSS));
endmodule
