ZeduloTech/gf180mcu-testchip2025/ip/efuse_spi_mem_256x8/efuse_spi_mem_256x8.nl.v

module efuse_spi_mem_256x8 (clk_i,
    npor,
    spi_clk,
    spi_csn,
    spi_miso,
    spi_mosi);
 input clk_i;
 input npor;
 input spi_clk;
 input spi_csn;
 output spi_miso;
 input spi_mosi;

 wire _0000_;
 wire _0001_;
 wire _0002_;
 wire _0003_;
 wire _0004_;
 wire _0005_;
 wire _0006_;
 wire _0007_;
 wire _0008_;
 wire _0009_;
 wire _0010_;
 wire _0011_;
 wire _0012_;
 wire _0013_;
 wire _0014_;
 wire _0015_;
 wire _0016_;
 wire _0017_;
 wire _0018_;
 wire _0019_;
 wire _0020_;
 wire _0021_;
 wire _0022_;
 wire _0023_;
 wire _0024_;
 wire _0025_;
 wire _0026_;
 wire _0027_;
 wire _0028_;
 wire _0029_;
 wire _0030_;
 wire _0031_;
 wire _0032_;
 wire _0033_;
 wire _0034_;
 wire _0035_;
 wire _0036_;
 wire _0037_;
 wire _0038_;
 wire _0039_;
 wire _0040_;
 wire _0041_;
 wire _0042_;
 wire _0043_;
 wire _0044_;
 wire _0045_;
 wire _0046_;
 wire _0047_;
 wire _0048_;
 wire _0049_;
 wire _0050_;
 wire _0051_;
 wire _0052_;
 wire _0053_;
 wire _0054_;
 wire _0055_;
 wire _0056_;
 wire _0057_;
 wire _0058_;
 wire _0059_;
 wire _0060_;
 wire _0061_;
 wire _0062_;
 wire _0063_;
 wire _0064_;
 wire _0065_;
 wire _0066_;
 wire _0067_;
 wire _0068_;
 wire _0069_;
 wire _0070_;
 wire _0071_;
 wire _0072_;
 wire _0073_;
 wire _0074_;
 wire _0075_;
 wire _0076_;
 wire _0077_;
 wire _0078_;
 wire _0079_;
 wire _0080_;
 wire _0081_;
 wire _0082_;
 wire _0083_;
 wire _0084_;
 wire _0085_;
 wire _0086_;
 wire _0087_;
 wire _0088_;
 wire _0089_;
 wire _0090_;
 wire _0091_;
 wire _0092_;
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
    .ZN(_0185_));
 gf180mcu_fd_sc_mcu7t5v0__or4_1 _0657_ (.A1(\spi2wb.spi_state[2] ),
    .A2(net214),
    .A3(net215),
    .A4(_0259_),
    .Z(_0204_));
 gf180mcu_fd_sc_mcu7t5v0__oai22_1 _0658_ (.A1(net214),
    .A2(net215),
    .B1(\spi2wb.spi_clk_reg ),
    .B2(_0219_),
    .ZN(_0205_));
 gf180mcu_fd_sc_mcu7t5v0__nand4_1 _0659_ (.A1(net248),
    .A2(_0284_),
    .A3(_0345_),
    .A4(_0205_),
    .ZN(_0206_));
 gf180mcu_fd_sc_mcu7t5v0__aoi221_1 _0660_ (.A1(net214),
    .A2(net74),
    .B1(net73),
    .B2(_0262_),
    .C(_0206_),
    .ZN(_0207_));
 gf180mcu_fd_sc_mcu7t5v0__or2_1 _0661_ (.A1(\spi2wb.spi_state[0] ),
    .A2(_0204_),
    .Z(_0208_));
 gf180mcu_fd_sc_mcu7t5v0__and2_1 _0662_ (.A1(net22),
    .A2(_0208_),
    .Z(_0209_));
 gf180mcu_fd_sc_mcu7t5v0__nand2_1 _0663_ (.A1(net19),
    .A2(_0208_),
    .ZN(_0210_));
 gf180mcu_fd_sc_mcu7t5v0__and2_1 _0664_ (.A1(_0204_),
    .A2(net21),
    .Z(_0211_));
 gf180mcu_fd_sc_mcu7t5v0__nand2_1 _0665_ (.A1(_0204_),
    .A2(_0207_),
    .ZN(_0212_));
 gf180mcu_fd_sc_mcu7t5v0__aoi21_1 _0666_ (.A1(\spi2wb.spi_counter[4] ),
    .A2(_0244_),
    .B(_0261_),
    .ZN(_0213_));
 gf180mcu_fd_sc_mcu7t5v0__oai22_1 _0667_ (.A1(_0223_),
    .A2(_0209_),
    .B1(_0212_),
    .B2(_0213_),
    .ZN(_0186_));
 gf180mcu_fd_sc_mcu7t5v0__oai32_1 _0668_ (.A1(_0245_),
    .A2(_0323_),
    .A3(_0212_),
    .B1(_0209_),
    .B2(_0226_),
    .ZN(_0187_));
 gf180mcu_fd_sc_mcu7t5v0__aoi22_1 _0669_ (.A1(_0227_),
    .A2(_0210_),
    .B1(_0211_),
    .B2(_0305_),
    .ZN(_0188_));
 gf180mcu_fd_sc_mcu7t5v0__and2_1 _0670_ (.A1(_0243_),
    .A2(_0290_),
    .Z(_0214_));
 gf180mcu_fd_sc_mcu7t5v0__aoi22_1 _0671_ (.A1(_0224_),
    .A2(_0210_),
    .B1(_0211_),
    .B2(_0214_),
    .ZN(_0189_));
 gf180mcu_fd_sc_mcu7t5v0__mux2_2 _0672_ (.I0(_0209_),
    .I1(_0212_),
    .S(\spi2wb.spi_counter[0] ),
    .Z(_0190_));
 gf180mcu_fd_sc_mcu7t5v0__clkinv_1 _0673_ (.I(net215),
    .ZN(_0215_));
 gf180mcu_fd_sc_mcu7t5v0__clkinv_1 _0674_ (.I(\spi2wb.spi_state[4] ),
    .ZN(_0216_));
 gf180mcu_fd_sc_mcu7t5v0__clkinv_1 _0675_ (.I(net216),
    .ZN(_0217_));
 gf180mcu_fd_sc_mcu7t5v0__clkinv_1 _0676_ (.I(\spi2wb.spi_clk_reg ),
    .ZN(_0218_));
 gf180mcu_fd_sc_mcu7t5v0__clkinv_1 _0677_ (.I(net3),
    .ZN(_0219_));
 gf180mcu_fd_sc_mcu7t5v0__clkinv_1 _0678_ (.I(net245),
    .ZN(_0220_));
 gf180mcu_fd_sc_mcu7t5v0__clkinv_1 _0679_ (.I(\spi2wb.spi_cmd_reg[1] ),
    .ZN(_0221_));
 gf180mcu_fd_sc_mcu7t5v0__clkinv_1 _0680_ (.I(\spi2wb.spi_cmd_reg[2] ),
    .ZN(_0222_));
 gf180mcu_fd_sc_mcu7t5v0__clkinv_1 _0681_ (.I(\spi2wb.spi_counter[4] ),
    .ZN(_0223_));
 gf180mcu_fd_sc_mcu7t5v0__clkinv_1 _0682_ (.I(\spi2wb.spi_counter[1] ),
    .ZN(_0224_));
 gf180mcu_fd_sc_mcu7t5v0__clkinv_1 _0683_ (.I(net208),
    .ZN(_0225_));
 gf180mcu_fd_sc_mcu7t5v0__clkinv_1 _0684_ (.I(\spi2wb.spi_counter[3] ),
    .ZN(_0226_));
 gf180mcu_fd_sc_mcu7t5v0__clkinv_1 _0685_ (.I(net209),
    .ZN(_0227_));
 gf180mcu_fd_sc_mcu7t5v0__inv_1 _0686_ (.I(\efuse_wb_mem.wb_cyc_i ),
    .ZN(_0228_));
 gf180mcu_fd_sc_mcu7t5v0__clkinv_1 _0687_ (.I(net217),
    .ZN(_0229_));
 gf180mcu_fd_sc_mcu7t5v0__clkinv_1 _0688_ (.I(\efuse_wb_mem.state[0] ),
    .ZN(_0230_));
 gf180mcu_fd_sc_mcu7t5v0__clkinv_1 _0689_ (.I(\efuse_wb_mem.counter[7] ),
    .ZN(_0231_));
 gf180mcu_fd_sc_mcu7t5v0__clkinv_1 _0690_ (.I(\efuse_wb_mem.counter[6] ),
    .ZN(_0232_));
 gf180mcu_fd_sc_mcu7t5v0__clkinv_1 _0691_ (.I(\efuse_wb_mem.counter[8] ),
    .ZN(_0233_));
 gf180mcu_fd_sc_mcu7t5v0__clkinv_1 _0692_ (.I(\spi2wb.spi_adr_reg[3] ),
    .ZN(_0234_));
 gf180mcu_fd_sc_mcu7t5v0__clkinv_1 _0693_ (.I(\efuse_wb_mem.wb_adr_i[0] ),
    .ZN(_0235_));
 gf180mcu_fd_sc_mcu7t5v0__clkinv_1 _0694_ (.I(\efuse_wb_mem.wb_adr_i[1] ),
    .ZN(_0236_));
 gf180mcu_fd_sc_mcu7t5v0__inv_1 _0695_ (.I(net230),
    .ZN(_0237_));
 gf180mcu_fd_sc_mcu7t5v0__clkinv_2 _0696_ (.I(net229),
    .ZN(_0238_));
 gf180mcu_fd_sc_mcu7t5v0__clkinv_1 _0697_ (.I(\efuse_wb_mem.sel[1] ),
    .ZN(_0239_));
 gf180mcu_fd_sc_mcu7t5v0__inv_1 _0698_ (.I(\efuse_wb_mem.sel[0] ),
    .ZN(_0240_));
 gf180mcu_fd_sc_mcu7t5v0__nor2_1 _0699_ (.A1(\spi2wb.spi_clk_reg ),
    .A2(_0219_),
    .ZN(_0241_));
 gf180mcu_fd_sc_mcu7t5v0__nor2_1 _0700_ (.A1(\spi2wb.spi_counter[1] ),
    .A2(net208),
    .ZN(_0242_));
 gf180mcu_fd_sc_mcu7t5v0__nand2_1 _0701_ (.A1(_0224_),
    .A2(_0225_),
    .ZN(_0243_));
 gf180mcu_fd_sc_mcu7t5v0__or4_1 _0702_ (.A1(\spi2wb.spi_counter[1] ),
    .A2(net208),
    .A3(\spi2wb.spi_counter[3] ),
    .A4(net209),
    .Z(_0244_));
 gf180mcu_fd_sc_mcu7t5v0__nor2_1 _0703_ (.A1(\spi2wb.spi_counter[4] ),
    .A2(_0244_),
    .ZN(_0245_));
 gf180mcu_fd_sc_mcu7t5v0__or2_1 _0704_ (.A1(\spi2wb.spi_counter[4] ),
    .A2(_0244_),
    .Z(_0246_));
 gf180mcu_fd_sc_mcu7t5v0__and2_1 _0705_ (.A1(net203),
    .A2(net121),
    .Z(_0247_));
 gf180mcu_fd_sc_mcu7t5v0__nand2_1 _0706_ (.A1(net202),
    .A2(net121),
    .ZN(_0248_));
 gf180mcu_fd_sc_mcu7t5v0__nor2_1 _0707_ (.A1(net4),
    .A2(_0247_),
    .ZN(_0249_));
 gf180mcu_fd_sc_mcu7t5v0__nand2_1 _0708_ (.A1(\spi2wb.spi_state[5] ),
    .A2(_0249_),
    .ZN(_0250_));
 gf180mcu_fd_sc_mcu7t5v0__nor4_1 _0709_ (.A1(\spi2wb.spi_cmd_reg[5] ),
    .A2(\spi2wb.spi_cmd_reg[4] ),
    .A3(\spi2wb.spi_cmd_reg[7] ),
    .A4(\spi2wb.spi_cmd_reg[6] ),
    .ZN(_0251_));
 gf180mcu_fd_sc_mcu7t5v0__or4_1 _0710_ (.A1(\spi2wb.spi_cmd_reg[5] ),
    .A2(\spi2wb.spi_cmd_reg[4] ),
    .A3(\spi2wb.spi_cmd_reg[7] ),
    .A4(\spi2wb.spi_cmd_reg[6] ),
    .Z(_0252_));
 gf180mcu_fd_sc_mcu7t5v0__or4_1 _0711_ (.A1(_0221_),
    .A2(\spi2wb.spi_cmd_reg[3] ),
    .A3(\spi2wb.spi_cmd_reg[2] ),
    .A4(_0252_),
    .Z(_0253_));
 gf180mcu_fd_sc_mcu7t5v0__nand2_1 _0712_ (.A1(\spi2wb.spi_state[2] ),
    .A2(_0247_),
    .ZN(_0254_));
 gf180mcu_fd_sc_mcu7t5v0__oai31_1 _0713_ (.A1(\spi2wb.spi_cmd_reg[0] ),
    .A2(_0253_),
    .A3(_0254_),
    .B(_0250_),
    .ZN(_0008_));
 gf180mcu_fd_sc_mcu7t5v0__nor4_1 _0714_ (.A1(_0220_),
    .A2(\spi2wb.spi_cmd_reg[1] ),
    .A3(\spi2wb.spi_cmd_reg[3] ),
    .A4(_0222_),
    .ZN(_0255_));
 gf180mcu_fd_sc_mcu7t5v0__nand2_1 _0715_ (.A1(net200),
    .A2(_0255_),
    .ZN(_0256_));
 gf180mcu_fd_sc_mcu7t5v0__nand2_1 _0716_ (.A1(net215),
    .A2(net74),
    .ZN(_0257_));
 gf180mcu_fd_sc_mcu7t5v0__oai22_1 _0717_ (.A1(_0216_),
    .A2(net4),
    .B1(_0256_),
    .B2(_0257_),
    .ZN(_0007_));
 gf180mcu_fd_sc_mcu7t5v0__aoi21_1 _0718_ (.A1(\spi2wb.spi_state[3] ),
    .A2(_0248_),
    .B(\spi2wb.spi_state[0] ),
    .ZN(_0258_));
 gf180mcu_fd_sc_mcu7t5v0__nor2_1 _0719_ (.A1(net4),
    .A2(_0258_),
    .ZN(_0006_));
 gf180mcu_fd_sc_mcu7t5v0__or2_1 _0720_ (.A1(\spi2wb.spi_state[4] ),
    .A2(net216),
    .Z(_0259_));
 gf180mcu_fd_sc_mcu7t5v0__oai31_1 _0721_ (.A1(\spi2wb.spi_state[0] ),
    .A2(_0248_),
    .A3(_0259_),
    .B(net4),
    .ZN(_0260_));
 gf180mcu_fd_sc_mcu7t5v0__aoi211_1 _0722_ (.A1(_0251_),
    .A2(net119),
    .B(_0215_),
    .C(_0246_),
    .ZN(_0261_));
 gf180mcu_fd_sc_mcu7t5v0__and2_1 _0723_ (.A1(_0241_),
    .A2(_0253_),
    .Z(_0262_));
 gf180mcu_fd_sc_mcu7t5v0__aoi22_1 _0724_ (.A1(\spi2wb.spi_state[5] ),
    .A2(net74),
    .B1(net72),
    .B2(_0262_),
    .ZN(_0263_));
 gf180mcu_fd_sc_mcu7t5v0__nand2_1 _0725_ (.A1(_0260_),
    .A2(_0263_),
    .ZN(_0003_));
 gf180mcu_fd_sc_mcu7t5v0__nand2_1 _0726_ (.A1(\spi2wb.spi_state[2] ),
    .A2(_0249_),
    .ZN(_0264_));
 gf180mcu_fd_sc_mcu7t5v0__oai21_1 _0727_ (.A1(_0253_),
    .A2(_0257_),
    .B(_0264_),
    .ZN(_0005_));
 gf180mcu_fd_sc_mcu7t5v0__or3_1 _0728_ (.A1(\efuse_wb_mem.counter[0] ),
    .A2(\efuse_wb_mem.counter[1] ),
    .A3(\efuse_wb_mem.counter[2] ),
    .Z(_0265_));
 gf180mcu_fd_sc_mcu7t5v0__or4_1 _0729_ (.A1(\efuse_wb_mem.counter[0] ),
    .A2(\efuse_wb_mem.counter[1] ),
    .A3(\efuse_wb_mem.counter[3] ),
    .A4(\efuse_wb_mem.counter[2] ),
    .Z(_0266_));
 gf180mcu_fd_sc_mcu7t5v0__or2_1 _0730_ (.A1(\efuse_wb_mem.counter[4] ),
    .A2(_0266_),
    .Z(_0267_));
 gf180mcu_fd_sc_mcu7t5v0__or2_1 _0731_ (.A1(\efuse_wb_mem.counter[5] ),
    .A2(_0267_),
    .Z(_0268_));
 gf180mcu_fd_sc_mcu7t5v0__nor4_2 _0732_ (.A1(\efuse_wb_mem.counter[5] ),
    .A2(\efuse_wb_mem.counter[4] ),
    .A3(\efuse_wb_mem.counter[6] ),
    .A4(_0266_),
    .ZN(_0269_));
 gf180mcu_fd_sc_mcu7t5v0__nand2_1 _0733_ (.A1(_0231_),
    .A2(net118),
    .ZN(_0270_));
 gf180mcu_fd_sc_mcu7t5v0__nor2_1 _0734_ (.A1(\efuse_wb_mem.counter[8] ),
    .A2(\efuse_wb_mem.counter[9] ),
    .ZN(_0271_));
 gf180mcu_fd_sc_mcu7t5v0__nand3_1 _0735_ (.A1(_0231_),
    .A2(net116),
    .A3(_0271_),
    .ZN(_0272_));
 gf180mcu_fd_sc_mcu7t5v0__nand4_1 _0736_ (.A1(net218),
    .A2(_0231_),
    .A3(net117),
    .A4(_0271_),
    .ZN(_0273_));
 gf180mcu_fd_sc_mcu7t5v0__nor2_1 _0737_ (.A1(_0228_),
    .A2(net217),
    .ZN(_0274_));
 gf180mcu_fd_sc_mcu7t5v0__nand2_1 _0738_ (.A1(net224),
    .A2(_0229_),
    .ZN(_0275_));
 gf180mcu_fd_sc_mcu7t5v0__aoi21_1 _0739_ (.A1(\efuse_wb_mem.state[0] ),
    .A2(_0275_),
    .B(\efuse_wb_mem.state[1] ),
    .ZN(_0276_));
 gf180mcu_fd_sc_mcu7t5v0__nand2_1 _0740_ (.A1(_0273_),
    .A2(_0276_),
    .ZN(_0001_));
 gf180mcu_fd_sc_mcu7t5v0__oai211_1 _0741_ (.A1(\spi2wb.spi_cmd_reg[0] ),
    .A2(_0253_),
    .B(_0247_),
    .C(\spi2wb.spi_state[2] ),
    .ZN(_0277_));
 gf180mcu_fd_sc_mcu7t5v0__oai21_1 _0742_ (.A1(_0217_),
    .A2(net4),
    .B(_0277_),
    .ZN(_0004_));
 gf180mcu_fd_sc_mcu7t5v0__and2_1 _0743_ (.A1(net218),
    .A2(_0272_),
    .Z(_0278_));
 gf180mcu_fd_sc_mcu7t5v0__clkinv_1 _0744_ (.I(_0278_),
    .ZN(_0279_));
 gf180mcu_fd_sc_mcu7t5v0__nand3_1 _0745_ (.A1(net223),
    .A2(\efuse_wb_mem.wb_we_i ),
    .A3(_0274_),
    .ZN(_0280_));
 gf180mcu_fd_sc_mcu7t5v0__nand2_1 _0746_ (.A1(_0279_),
    .A2(_0280_),
    .ZN(_0002_));
 gf180mcu_fd_sc_mcu7t5v0__nand2_1 _0747_ (.A1(net207),
    .A2(\spi2wb.wr_req ),
    .ZN(_0281_));
 gf180mcu_fd_sc_mcu7t5v0__oai21_4 _0748_ (.A1(\spi2wb.rd_req ),
    .A2(\spi2wb.wr_req ),
    .B(net207),
    .ZN(_0282_));
 gf180mcu_fd_sc_mcu7t5v0__nand2_1 _0749_ (.A1(_0275_),
    .A2(_0282_),
    .ZN(_0009_));
 gf180mcu_fd_sc_mcu7t5v0__nand3_1 _0750_ (.A1(net216),
    .A2(\spi2wb.spi_clk_reg ),
    .A3(_0219_),
    .ZN(_0283_));
 gf180mcu_fd_sc_mcu7t5v0__oai22_1 _0751_ (.A1(net224),
    .A2(_0277_),
    .B1(_0283_),
    .B2(_0246_),
    .ZN(_0610_[0]));
 gf180mcu_fd_sc_mcu7t5v0__and2_4 _0752_ (.A1(net248),
    .A2(\spi2wb.wren_reg ),
    .Z(net198));
 gf180mcu_fd_sc_mcu7t5v0__nor4_1 _0753_ (.A1(_0228_),
    .A2(net217),
    .A3(_0230_),
    .A4(\efuse_wb_mem.wb_we_i ),
    .ZN(_0000_));
 gf180mcu_fd_sc_mcu7t5v0__and3_1 _0754_ (.A1(net214),
    .A2(net207),
    .A3(net74),
    .Z(_0010_));
 gf180mcu_fd_sc_mcu7t5v0__oai21_1 _0755_ (.A1(_0218_),
    .A2(net3),
    .B(_0259_),
    .ZN(_0284_));
 gf180mcu_fd_sc_mcu7t5v0__oai21_1 _0756_ (.A1(\spi2wb.spi_state[0] ),
    .A2(_0259_),
    .B(_0284_),
    .ZN(_0285_));
 gf180mcu_fd_sc_mcu7t5v0__nand2_1 _0757_ (.A1(net6),
    .A2(_0285_),
    .ZN(_0286_));
 gf180mcu_fd_sc_mcu7t5v0__nand2_1 _0758_ (.A1(_0224_),
    .A2(net208),
    .ZN(_0287_));
 gf180mcu_fd_sc_mcu7t5v0__oai22_1 _0759_ (.A1(\spi2wb.wb_datrd_reg[0] ),
    .A2(_0243_),
    .B1(_0287_),
    .B2(\spi2wb.wb_datrd_reg[1] ),
    .ZN(_0288_));
 gf180mcu_fd_sc_mcu7t5v0__nand2_1 _0760_ (.A1(\spi2wb.spi_counter[1] ),
    .A2(_0225_),
    .ZN(_0289_));
 gf180mcu_fd_sc_mcu7t5v0__nand2_1 _0761_ (.A1(\spi2wb.spi_counter[1] ),
    .A2(net208),
    .ZN(_0290_));
 gf180mcu_fd_sc_mcu7t5v0__oai22_1 _0762_ (.A1(\spi2wb.wb_datrd_reg[2] ),
    .A2(_0289_),
    .B1(_0290_),
    .B2(\spi2wb.wb_datrd_reg[3] ),
    .ZN(_0291_));
 gf180mcu_fd_sc_mcu7t5v0__aoi21_1 _0763_ (.A1(_0216_),
    .A2(_0288_),
    .B(_0291_),
    .ZN(_0292_));
 gf180mcu_fd_sc_mcu7t5v0__nor2_1 _0764_ (.A1(\spi2wb.spi_counter[0] ),
    .A2(net224),
    .ZN(_0293_));
 gf180mcu_fd_sc_mcu7t5v0__oai21_1 _0765_ (.A1(_0225_),
    .A2(\spi2wb.wren_reg ),
    .B(_0224_),
    .ZN(_0294_));
 gf180mcu_fd_sc_mcu7t5v0__oai31_1 _0766_ (.A1(\spi2wb.spi_counter[2] ),
    .A2(_0293_),
    .A3(_0294_),
    .B(\spi2wb.spi_state[4] ),
    .ZN(_0295_));
 gf180mcu_fd_sc_mcu7t5v0__nand4_1 _0767_ (.A1(\spi2wb.spi_clk_reg ),
    .A2(_0219_),
    .A3(_0259_),
    .A4(_0295_),
    .ZN(_0296_));
 gf180mcu_fd_sc_mcu7t5v0__oai22_1 _0768_ (.A1(\spi2wb.wb_datrd_reg[4] ),
    .A2(_0243_),
    .B1(_0290_),
    .B2(\spi2wb.wb_datrd_reg[7] ),
    .ZN(_0297_));
 gf180mcu_fd_sc_mcu7t5v0__oai22_1 _0769_ (.A1(\spi2wb.wb_datrd_reg[5] ),
    .A2(_0287_),
    .B1(_0289_),
    .B2(\spi2wb.wb_datrd_reg[6] ),
    .ZN(_0298_));
 gf180mcu_fd_sc_mcu7t5v0__oai21_1 _0770_ (.A1(_0297_),
    .A2(_0298_),
    .B(net209),
    .ZN(_0299_));
 gf180mcu_fd_sc_mcu7t5v0__oai21_1 _0771_ (.A1(net209),
    .A2(_0292_),
    .B(_0299_),
    .ZN(_0300_));
 gf180mcu_fd_sc_mcu7t5v0__oai21_1 _0772_ (.A1(_0296_),
    .A2(_0300_),
    .B(_0286_),
    .ZN(_0011_));
 gf180mcu_fd_sc_mcu7t5v0__nand3_2 _0773_ (.A1(net214),
    .A2(net248),
    .A3(net202),
    .ZN(_0301_));
 gf180mcu_fd_sc_mcu7t5v0__oai21_1 _0774_ (.A1(_0246_),
    .A2(_0301_),
    .B(\spi2wb.spi_dat_reg[0] ),
    .ZN(_0302_));
 gf180mcu_fd_sc_mcu7t5v0__nand2_1 _0775_ (.A1(net245),
    .A2(net122),
    .ZN(_0303_));
 gf180mcu_fd_sc_mcu7t5v0__oai21_1 _0776_ (.A1(_0301_),
    .A2(_0303_),
    .B(_0302_),
    .ZN(_0012_));
 gf180mcu_fd_sc_mcu7t5v0__nor3_1 _0777_ (.A1(\spi2wb.spi_counter[4] ),
    .A2(\spi2wb.spi_counter[1] ),
    .A3(_0225_),
    .ZN(_0304_));
 gf180mcu_fd_sc_mcu7t5v0__xor2_1 _0778_ (.A1(_0227_),
    .A2(_0242_),
    .Z(_0305_));
 gf180mcu_fd_sc_mcu7t5v0__xor2_1 _0779_ (.A1(net209),
    .A2(net201),
    .Z(_0306_));
 gf180mcu_fd_sc_mcu7t5v0__nor2_1 _0780_ (.A1(\spi2wb.spi_counter[3] ),
    .A2(_0306_),
    .ZN(_0307_));
 gf180mcu_fd_sc_mcu7t5v0__nand3_1 _0781_ (.A1(_0226_),
    .A2(net102),
    .A3(net101),
    .ZN(_0308_));
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
    net155,
    net156,
    net157,
    net158,
    net159,
    net160,
    net161,
    \efuse_wb_mem.bit_sel[30] ,
    net164,
    net165,
    net166,
    net167,
    net168,
    net169,
    net170,
    net171,
    net172,
    net173,
    net175,
    net176,
    net177,
    net178,
    net179,
    \efuse_wb_mem.bit_sel[14] ,
    \efuse_wb_mem.bit_sel[13] ,
    \efuse_wb_mem.bit_sel[12] ,
    net181,
    net182,
    net123,
    net124,
    net125,
    net126,
    net131,
    net142,
    \efuse_wb_mem.bit_sel[3] ,
    net163,
    net174,
    net183}),
    .COL_PROG_N({\efuse_wb_mem.col_prog_n[15] ,
    \efuse_wb_mem.col_prog_n[14] ,
    \efuse_wb_mem.col_prog_n[13] ,
    \efuse_wb_mem.col_prog_n[12] ,
    \efuse_wb_mem.col_prog_n[11] ,
    \efuse_wb_mem.col_prog_n[10] ,
    \efuse_wb_mem.col_prog_n[9] ,
    \efuse_wb_mem.col_prog_n[8] }),
    .OUT({\efuse_wb_mem.efuse_out[15] ,
    \efuse_wb_mem.efuse_out[14] ,
    \efuse_wb_mem.efuse_out[13] ,
    \efuse_wb_mem.efuse_out[12] ,
    \efuse_wb_mem.efuse_out[11] ,
    \efuse_wb_mem.efuse_out[10] ,
    \efuse_wb_mem.efuse_out[9] ,
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
