ZeduloTech/gf180mcu-testchip2025/(commit log)

2025-10-16 Initial commit of Caravel adapted for the wafer.space gf180mcu-project-template
    [pin.cfg]
2025-11-16 Fix a bunch of problems with timing & antenna. Add several original & modified Caravel tests launched from cocotb
    [pin.cfg]
2025-11-19 Disable KLayout antenna
2025-11-22 Add oscillator netlist to fix GL sim in CI
    [ring_osc2x13.pnl.v]
2025-11-23 Two efuse blocks & WB arbiter. Has PDN issues.
    [efuse_wb_mem_64x8__nom_tt_025C_5v00.sdf]
2025-11-24 Fix PDN & CI.
    [chip_top_tb.py, config.yaml, efuse_rw_tb.v]
2025-11-27 Add 4 final eFuse blocks & WB mux.
    [efuse_wb_mem_128x8__max_ff_n40C_5v50.sdf, efuse_wb_mem_128x8__max_ss_125C_4v50.sdf, efuse_wb_mem_128x8__max_tt_025C_5v00.sdf, efuse_wb_mem_128x8__min_ff_n40C_5v50.sdf, efuse_wb_mem_128x8__min_ss_125C_4v50.sdf, efuse_wb_mem_128x8__min_tt_025C_5v00.sdf, efuse_wb_mem_128x8__nom_ff_n40C_5v50.sdf, efuse_wb_mem_128x8__nom_ss_125C_4v50.sdf]
2025-11-27 Added SRAM blocks to chip, currently not actively used
2025-11-30 Update eFuse macros & other small fixes.
    [efuse_wb_mem_1024x32__max_ff_n40C_5v50.sdf, efuse_wb_mem_1024x32__max_ss_125C_4v50.sdf, efuse_wb_mem_1024x32__max_tt_025C_5v00.sdf, efuse_wb_mem_1024x32__min_ff_n40C_5v50.sdf, efuse_wb_mem_1024x32__min_ss_125C_4v50.sdf, efuse_wb_mem_1024x32__min_tt_025C_5v00.sdf, efuse_wb_mem_1024x32__nom_ff_n40C_5v50.sdf, efuse_wb_mem_1024x32__nom_ss_125C_4v50.sdf]
2025-11-30 SRAM test pin config
2025-11-30 Fix config for CI
    [config.yaml]
2025-12-01 Update Caravel a bit & fix sealring issue
    [pin.cfg, ring_osc2x13__max_ff_n40C_5v50.sdf, ring_osc2x13__max_ss_125C_4v50.sdf, ring_osc2x13__max_tt_025C_5v00.sdf, ring_osc2x13__min_ff_n40C_5v50.sdf, ring_osc2x13__min_ss_125C_4v50.sdf, ring_osc2x13__min_tt_025C_5v00.sdf, ring_osc2x13__nom_ff_n40C_5v50.sdf]
2025-12-01 Fix for Magic DRC errors in SRAMs
    [config.yaml]
2025-12-03 Add 1-byte async eFuse block. Add one more Caravel test & improve others a bit.
    [efuse_async_mem_1x8__max_ff_n40C_5v50.sdf, efuse_async_mem_1x8__max_ss_125C_4v50.sdf, efuse_async_mem_1x8__max_tt_025C_5v00.sdf, efuse_async_mem_1x8__min_ff_n40C_5v50.sdf, efuse_async_mem_1x8__min_ss_125C_4v50.sdf, efuse_async_mem_1x8__min_tt_025C_5v00.sdf, efuse_async_mem_1x8__nom_ff_n40C_5v50.sdf, efuse_async_mem_1x8__nom_ss_125C_4v50.sdf]
2025-12-08 Update efuse macros
    [efuse_wb_mem_1024x32__max_ff_n40C_5v50.sdf, efuse_wb_mem_1024x32__max_ss_125C_4v50.sdf, efuse_wb_mem_1024x32__max_tt_025C_5v00.sdf, efuse_wb_mem_1024x32__min_ff_n40C_5v50.sdf, efuse_wb_mem_1024x32__min_ss_125C_4v50.sdf, efuse_wb_mem_1024x32__min_tt_025C_5v00.sdf, efuse_wb_mem_1024x32__nom_ff_n40C_5v50.sdf, efuse_wb_mem_1024x32__nom_ss_125C_4v50.sdf]
2025-12-09 Update Caravel to remove antenna errors
2025-12-09 macro: uart2gpi macro created
2025-12-10 Add cocotb test for the SPI SRAMs
2025-12-11 Updated pinout for uart2gpi
2025-12-11 Add 4 more async eFuse blocks connected to the Wishbone. Move macros a bit. Fix pinout for SRAM & uart2gpi blocks.
    [async_wb_efuse.c, async_wb_efuse_tb.v, caravel_sim_wrapper.v, chip_core.sv, chip_top_tb.py, config.yaml, efuse_array_32x8.v, efuse_array_64x32.v]
2025-12-11 Small fix for GL sim
    [chip_top_tb.py, efuse_async_array_1x8.v]
2025-12-11 UART2GPI (GPIO/PWM/I2C) macro added with /final and config/core module inclusion
    [metrics.csv, uart2gpi__max_ff_n40C_5v50.sdf, uart2gpi__max_ss_125C_4v50.sdf, uart2gpi__max_tt_025C_5v00.sdf, uart2gpi__min_ff_n40C_5v50.sdf, uart2gpi__min_ss_125C_4v50.sdf, uart2gpi__min_tt_025C_5v00.sdf, uart2gpi__nom_ff_n40C_5v50.sdf]
2025-12-12 Fix sim after addition of uart2gpi
    [async_wb_efuse_tb.v, chip_core.sv, chip_top_tb.py]
2025-12-14 Add SPI efuse block
    [efuse_spi_mem_256x8__max_ff_n40C_5v50.sdf, efuse_spi_mem_256x8__max_ss_125C_4v50.sdf, efuse_spi_mem_256x8__max_tt_025C_5v00.sdf, efuse_spi_mem_256x8__min_ff_n40C_5v50.sdf, efuse_spi_mem_256x8__min_ss_125C_4v50.sdf, efuse_spi_mem_256x8__min_tt_025C_5v00.sdf, efuse_spi_mem_256x8__nom_ff_n40C_5v50.sdf, efuse_spi_mem_256x8__nom_ss_125C_4v50.sdf]
2025-12-14 Small fixes & add one more test
    [chip_core.sv, chip_top_tb.py, config.yaml, efuse_as_spiflash_tb.v, sramtest_sim_wrapper.v, uspi_sramtest.sv]
2025-12-14 UART2GPIO pin fix
2025-12-15 uart macro: testbench added
2025-12-16 Add uart2gpi test to the test sequence
2025-12-17 Shorten GL sim tests in CI
    [chip_top_tb.py, efuse_rw.c, efuse_rw_tb.v]
